nokia/ECG-PPG-integrated-electronic-stethoscope/docs/Patchkeeper_data_packet_info_V3x.docx

# Patchkeeper data format details

#### Packet head info:

typedef struct packet_info_struct {

uint32_t sop;

uint32_t timestamp_hi; // If we represent this as 64-bit we have alignment issues with padding added

uint32_t timestamp_lo; // So send as two 32-bit numbers and put together in the app.

uint8_t logger_id;

uint8_t custom; // Makes the structure end 32-bit aligned;

uint16_t length;

} packet_info_t;

## Config packet format:

// FIRMWARE VERSION information define at the beginning of sdk_config.h file
# define FIRMWARE_VERSION_ID FIRMWARE_MAJOR_VERSION * 1 00 00 00 + \
FIRMWARE_MINOR_VERSION * 1 00 00 + \
FIRMWARE_PATCH_NUM * 1 00 + \
FIRMWARE_BUILD_NUM

Example for version 1012: 1000102, saved as 4 bytes integral

#define LOGGER_CONFIG_DATA_LENGTH_BYTES 32
#define LOGGER_CONFIG_ID 0x00

typedef struct {
packet_info_t packet_info;
int8_t data[LOGGER_CONFIG_DATA_LENGTH_BYTES]; // 32 bytes of data
} config_data_t;

config_data.packet_info.sop = SOP_BELLLABS;
config_data.packet_info.timestamp_lo = timestamp.lo;
config_data.packet_info.timestamp_hi = timestamp.hi;
config_data.packet_info.logger_id = LOGGER_CONFIG_ID;
config_data.packet_info.length = LOGGER_CONFIG_DATA_LENGTH_BYTES; //32
config_data.packet_info.custom = packet_count++;

### packet info format:

6C-6C-65-42 | -00-00-00-00 | -A4-EA-5C-00 | -00 | -00-00 | -20
SOP_BELLLABS: lleB | timestamp.hi ts_hi: | timestamp.lo ts_lo: 4 bytes | logger ID: 0x00 config data | packet_count | data length (max 242) 0x20 : 32 bytes
4 bytes | 4 bytes | 4 bytes | 1 byte | 1 byte | 2 bytes

### 242 = 242 (244 -2 because of packet_count)

### then followed by config data:

### Followed by config data info (32 bytes in the following format, data length in header should be 0x20):

// Change the pointer type so it is transferred correctly.
uint32_t *data32 = (uint32_t*) config_data.data;
uint16_t *data16 = (uint16_t*) config_data.data;

*data32 = NRF_RTC2->PRESCALER;
*(data16+2) = RTC_INPUT_FREQ;
*(data16+3) = CONFIG_DATA_VERSION;

*(data32+2) = m_timestamp_offset.lo;
*(data32+3) = m_timestamp_offset.hi;
*(data32+4) = m_old_timestamp_offset.lo;
*(data32+5) = m_old_timestamp_offset.hi;
*(data32+6) = FIRMWARE_VERSION_ID;
*(data32+7) = m_last_reset_reason;

config data format:

NRF_RTC2->PRESCALER | RTC_INPUT_FRE | CONFIG_DATA_VERSION | m_timestamp_offset.lo | m_timestamp_offset.hi | m_old_timestamp_offset.lo | m_old_timestamp_offset.hi | FIRMWARE_VERSION_ID | m_last_reset_reason
4 bytes | 2 bytes | 2 bytes | 4 bytes | 4 bytes | 4 bytes | 4 bytes | 4 bytes | 4 bytes

Python script for processing config data:

def process_config_data(SensorData):

global PrescalerValue

global RTCInputFrequency

global Ticks_per_second

global DataPackingVersion

# print("Config Data Handler")

PrescalerValue = (SensorData[3] << 24 | SensorData[2] << 16 << SensorData[1] << 8 | SensorData[0])

RTCInputFrequency = (SensorData[5] << 8 | SensorData[4])

DataPackingVersion = (SensorData[7] << 8 | SensorData[6])

print("Updating PrescalarValue to ", PrescalerValue)

print("Updating RTC Input Frequency to ", RTCInputFrequency)

print("Data Format Version(should be 3): ", DataPackingVersion)

Ticks_per_second = RTCInputFrequency / (PrescalerValue + 1)

return

## Data packet format from all Sensors

Battery 0x05 6C-6C-65-42-00-00-00-00-7F-4B-78-00-05-02-17-00-56-D8-00-00

IMU: 0x2A 6C-6C-65-42-00-00-00-00-56-4F-78-00-2A-10-C1-12-03-00-09-00-03-00-68-04-12-00-F7-BC-D6-24-5D-00

GSR:0x22 6C-6C-65-42-00-00-00-00-DD-51-78-00-22-10-60-00-79-4B-78-00-00-90-19-40-DD-51-78-00-00-90-19-40

Strain: 0x24 6C-6C-65-42-00-00-00-00-E1-51-78-00-24-10-60-00-7A-4B-78-00-01-F4-3F-40-E1-51-78-00-01-F4-3F-40

Pulse: 0x26 6C-6C-65-42-00-00-00-00-E9-51-78-00-26-10-60-00-7B-4B-78-00-01-F4-3F-40-E9-51-78-00-01-F4-3F-40

Temperture 0x28: 6C-6C-65-42-00-00-00-00-82-4B-78-00-28-10-77-00-86-CB-77-00-01-F4-3F-40-82-4B-78-00-01-F4-3F-40

ECG: 0x02: 6C-6C-65-42-00-00-00-00-B7-9A-2D-00-20-E4-C5-01-B7-9A-2D-00-01-00-7F-FF-FF-01-12-F2-61-9B-2D-00-01-01-7F-FF-FF-01-13-15-67-9C-2D-00-01-02-7F-FF-FF-01-13-70-6D-9D-2D-00-01-03-7F-FF-FF-01-13-39-74-9E-2D-00-01-04-7F-FF-FF-01-13-3E-0F-A1-2D-00-01-05-7F-FF-FF-01-13-4B-87-A1-2D-00-01-06-7F-FF-FF-01-13-17-8E-A2-2D-00-01-07-7F-FF-FF-01-13-16-94-A3-2D-00-01-08-7F-FF-FF-01-13-2D-9A-A4-2D-00-01-09-7F-FF-FF-01-13-33-7A-A7-2D-00-01-0A-7F-FF-FF-01-13-51-AE-A7-2D-00-01-0B-7F-FF-FF-01-13-64-B4-A8-2D-00-01-0C-7F-FF-FF-01-13-64-BA-A9-2D-00-01-0D-7F-FF-FF-01-13-58-C1-AA-2D-00-01-0E-7F-FF-FF-01-13-43-DB-AD-2D-00-01-0F-7F-FF-FF-01-13-35-DB-AE-2D-00-01-10-7F-FF-FF-01-13-44-E2-AF-2D-00-01-11-7F-FF-FF-01-13-79-E7-B0-2D-00-01-12-7F-FF-FF-01-13-6A

16 bytes packet_info + subpackets

typedef struct {
packet_info_t packet_info;
adc_sensor_data_buffer_t data[PATCHKEEPER_TEMP_BUFFER_SIZE];
} patchkeeper_temp_data_t;

### Packet head info:

typedef struct packet_info_struct {

uint32_t sop;

uint32_t timestamp_hi; // If we represent this as 64-bit we have alignment issues with padding added

uint32_t timestamp_lo; // So send as two 32-bit numbers and put together in the app.

uint8_t logger_id;

uint8_t custom; // Makes the structure end 32-bit aligned;

uint16_t length;

} packet_info_t;

| | Bytes | bits
6C-6C-65-42 | lleB | 4 | 32
-00-00-00-00 | timestamp_hi | 4 | 32
-30-71-06-00 | timestamp_lo | 4 | 32
-22 (24, 26 0r 28) | logger_id | 1 | 8
-05 | data subpacket count (cycling 0-255): 0x05 | 1 | 8
-E4-00 | length0x00E4(LSB first): it changes from 1 byte (V2 and before)to 2 bytes (V3) for streaming/save large amount of data without a new header. Custom for subpacket counting reduced to 1 byte: 0x10: 16 bytes for 2 readings of each sensor : ts_lo (4) and float_t (4) 0xE4: 228bytes for ECG 0x02: 2 bytes for battery percentage and coded voltage (padded with 2 bytes of 0 for saving and streaming) 0x10: 16 bytes for IMU: 2 bytes each value gyro.x, y, z, accel.x, y, z, ts_lo (4) 0x04: 4 bytes for Audio mean and peak, 2 bytes each (16 bits integral) | 2 | 16
Then followed by | 20 sub-packets of this: total 160 bytes | 16 bytes of header for all BLE packets
-DF-0C-05-00 | : timestamp_lo of individual sub-packet | 4 | 32
-CE-BC-54-40 | : float 32 bit float_t data (reading of voltage): 3.32402 | 4 | 32
-AC-19-05-00 | :second sub-packet, timestamp_lo of individual packet | 4 | 32
-CE-74-54-40 | :second packet,t 32 bit float_t data (voltage) : 3.31963 | 4 | 32

## length of following data: multiples of subpackets:

## 16 bytes for analog sensor data, multiple of 8 bytes

## 228 for ECG data, multiple of 12 bytes

## IMU and battery data are the same as in Gecko device.

## 2 bytes for battery data:

Analog sensors: 8 bytes x 2 data points (4 bytes for ts_lo and 4 bytes for float value)

ECG: 12 bytes x 19 supbackets

Batt: 2 bytes x 1 reading //PATCHKEEPER_BATT_DATA_LENGTH_BYTES

Audio mean and peak: PATCHKEEPER_AUDIO_RESULT_DATA_LENGTH_BYTES*sizeof(audio_memory_t);

#### IMU sensor data subpacket format:

#define PATCHKEEPER_IMU_DATA_LENGTH_BYTES 16

#define PATCHKEEPER_IMU_DATA_LENGTH_HALF_WORDS PATCHKEEPER_IMU_DATA_LENGTH_BYTES/2

#define PATCHKEEPER_IMU_ID 0x2a

typedef struct {
packet_info_t packet_info;
int16_t data[PATCHKEEPER_IMU_DATA_LENGTH_HALF_WORDS]; = data[8]
} imu_data_t;

typedef struct {
bmi160_sensor_data_simple_t gyro_data;
bmi160_sensor_data_simple_t accel_data;
uint32_t sensortime;

} imu_data_packed_t;

6C-6C-65-42 | -00-00-00-00 | -A4-EA-5C-00 | -2A | -10-00 | -79 | -FE-FF | -F9-FF | -FE-FF | -5E-04 | -8C-00 | -FE-BC | -C1-EC- -47-00
lleB | ts_hi | ts_lo | 0x2A for IMU | length:0x10: means 16 bytes data | custom : sequence | gyro.x | gyro.y | gyro.z | accel.x | accel.y | accel.z | imu_internal_ts
4 bytes | 4 bytes | 4 bytes | 1 byte | 2 bytes | 1 byte | 2 | 2 | 2 | 2 | 2 | 2 | 4

##### python scripts for processing IMU data (from Gecko):

def process_imu_data(SensorData):

# gx = int(SensorData[1] << 8 | SensorData[0])

# gy = int(SensorData[3] << 8 | SensorData[2])

# gz = int(SensorData[5] << 8 | SensorData[4])

# ax = int(SensorData[7] << 8 | SensorData[6])

# ay = int(SensorData[9] << 8 | SensorData[8])

# az = int(SensorData[11] << 8 | SensorData[10])

gx = 125*3.14159/(2**16*180)*int.from_bytes(SensorData[0:2],byteorder='little',signed=True)

gy = 125*3.14159/(2**16*180)*int.from_bytes(SensorData[2:4],byteorder='little',signed=True)

gz = 125*3.14159/(2**16*180)*int.from_bytes(SensorData[4:6],byteorder='little',signed=True)

ax = 9.80665/2**14*int.from_bytes(SensorData[6:8],byteorder='little',signed=True)

ay = 9.80665/2**14*int.from_bytes(SensorData[8:10],byteorder='little',signed=True)

az = 9.80665/2**14*int.from_bytes(SensorData[10:12],byteorder='little',signed=True)

imu_internal_ts = (SensorData[14] << 16 | SensorData[13] << 8 | SensorData[12])

return {'type':'imu_ts','gx':gx,'gy':gy,'gz':gz,'ax':ax,'ay':ay,'az':az,'imu_internal_ts':imu_internal_ts}

#### Analog sensors data format:

### PATCHKEEPER_GSR_ID 0x22

### PATCHKEEPER_STRAIN_ID 0x24

### PATCHKEEPER_PULSE_ID 0x26

### PATCHKEEPER_TEMP_ID 0x28

#define PATCHKEEPER_GSR_BUFFER_SIZE 2
#define PATCHKEEPER_STRAIN_BUFFER_SIZE 2

#define PATCHKEEPER_PULSE_BUFFER_SIZE 2

#define PATCHKEEPER_TEMP_BUFFER_SIZE 2

typedef struct {
uint32_t ts_lo; // 4 bytes
float_t value; // 4 bytes
} adc_sensor_data_buffer_t; // 8 bytes total

typedef struct {
packet_info_t packet_info;
adc_sensor_data_buffer_t data[PATCHKEEPER_GSR_BUFFER_SIZE];
} patchkeeper_gsr_data_t;

typedef struct {
packet_info_t packet_info;
adc_sensor_data_buffer_t data[PATCHKEEPER_STRAIN_BUFFER_SIZE];
} patchkeeper_strain_data_t;

typedef struct {
packet_info_t packet_info;
adc_sensor_data_buffer_t data[PATCHKEEPER_PULSE_BUFFER_SIZE];
} patchkeeper_pulse_data_t;

typedef struct {
packet_info_t packet_info;
adc_sensor_data_buffer_t data[PATCHKEEPER_TEMP_BUFFER_SIZE];
} patchkeeper_temp_data_t;

#define PATCHKEEPER_GSR_DATA_LENGTH_BYTES PATCHKEEPER_GSR_BUFFER_SIZE * sizeof(adc_sensor_data_buffer_t)

#define PATCHKEEPER_STRAIN_DATA_LENGTH_BYTES PATCHKEEPER_STRAIN_BUFFER_SIZE * sizeof(adc_sensor_data_buffer_t)
#define PATCHKEEPER_PULSE_DATA_LENGTH_BYTES PATCHKEEPER_PULSE_BUFFER_SIZE * sizeof(adc_sensor_data_buffer_t)
#define PATCHKEEPER_TEMP_DATA_LENGTH_BYTES PATCHKEEPER_TEMP_BUFFER_SIZE * sizeof(adc_sensor_data_buffer_t)

6C-6C-65-42 | -00-00-00-00 | -DD-51-78-00 | -22 | -10-00 | -60 | -79-4B-78-00 | -00-90-19-40 | -DD-51-78-00 | -00-90-19-40
lleB | ts_hi | ts_lo | 0x22/ 0x24/ 0x26/ 0x28 | length:0x10: 16 bytes data | custom 1 byte: sequence No. of packets | ts_lo1: 4 bytes | adc reading1, float_t: 4 bytes | ts_lo2: 4 bytes | adc reading2, float_t, 4bytes
4 bytes | 4 bytes | 4 | 1 | 2 | 1 | 4 | 4 | 4 | 4

#### Battery data format

There is no subpacket for battery data:

typedef struct {
packet_info_t packet_info;
uint8_t data[PATCHKEEPER_BATT_DATA_LENGTH_BYTES];
} patchkeeper_batt_data_t;

### PATCHKEEPER_BATT_ID 0x05

#define PATCHKEEPER_BATT_BUFFER_SIZE 1

#define PATCHKEEPER_BATT_DATA_LENGTH_BYTES PATCHKEEPER_BATT_BUFFER_SIZE * sizeof(nrf_saadc_value_t) // 1X16 Bits

Battery :

6C-6C-65-42 | -00-00-00-00 | -7F-4B-78-00 | -05 | -02-00 | -17 | -56 | -D8 | -00-00
lleB | ts_hi: 4 bytes | ts_lo: 4 bytes | 0x05: Battery_ID | length:0x02: means 2 bytes data | custom 1 byte: sequence No. of packets | battery_level_Percent (86%) | coded_vbatt_8: 216 in decimal | padded for alignment 32 bits
4 bytes | 4 | 4 | 1 | 2 | 1 | 1 | 1 | 2

python processing battery data (from Gecko):

def process_battery_data(SensorData):

battery_percent = (SensorData[0])

if (DataPackingVersion>=1):

battery_volt = 3.0 + SensorData[1]/200.0;

else:

battery_volt = (SensorData[1]+300.0)/100.0;

battery_level = battery_volt

return {'type':'battery_ts','battery_percent':battery_percent,'battery_level':battery_level}

#### ECG data subpacket format

Each ECG BLE packet contains: 16 bytes of header + 19 subpackets of data, total length = 12 x 19 = 228 bytes

Total bytes: 16+12 x 19 =244 each BLE packet

(To make receiving end parsing data easier, all data packets are formatted with header (16 bytes),

therefor maximum number of subpackets : 19 ( (244 -16)/12 = 19 ))

PATCHKEEPER_ECG_ID 0x20, data as following:

6C-6C-65-42-00-00-00-00-74-83-07-00-20-E4-47-000-74-83-07-00-01-00-7F-FF-FF-2B-B9-89-44-84-07-00-01-01-7F-FF-FF-2B-B4-E9-4B-85-07-00-01-02-7F-FF-FF-2B-B0-08-51-86-07-00-01-03-7F-FF-FF-2B-AA-9F-D9-89-07-00-01-04-7F-FF-FF-2B-9A-1D-6B-8A-07-00-01-05-7F-FF-FF-2B-95-27-71-8B-07-00-01-06-7F-FF-FF-2B-90-1B-78-8C-07-00-01-07-7F-FF-FF-2B-8A-63-7E-8D-07-00-01-08-7F-FF-FF-2B-85-1D-3E-90-07-00-01-09-7F-FF-FF-2B-7A-4B-91-90-07-00-01-0A-7F-FF-FF-2B-75-0A-97-91-07-00-01-0B-7F-FF-FF-2B-70-00-9E-92-07-00-01-0C-7F-FF-FF-2B-6B-12-A4-93-07-00-01-0D-7F-FF-FF-2B-66-13-A4-96-07-00-01-0E-7F-FF-FF-2B-5B-23-BA-96-07-00-01-0F-7F-FF-FF-2B-55-BF-BE-97-07-00-01-10-7F-FF-FF-2B-50-A8-C4-98-07-00-01-11-7F-FF-FF-2B-4B-21-CB-99-07-00-01-12-7F-FF-FF-2B-45-74

6C-6C-65-42 | -00-00-00-00 | -74-83-07-00 | -20 | -E4-00 | -47 | -74-83-07-00 | -01- | -00- | -7F-FF-FF | --2B-B9-89
lleB | ts_hi: 4 bytes | ts_lo: 4 bytes | 0x20 ECG_ID | length:0xE4: means 228 bytes data | custom 1 byte: sequence No. of packets | ts_lo1: 4 bytes, time stamp of each data point | 1 byte status from ADS1992 | 1 byte subpacket count | 3 bytes of channel 1 data | 3 bytes of channel 2 data
4 bytes | 4 | 4 | 1 | 2 | 1 | 4 | 1 | 1 | 3 | 3

The above grey part repeats 19 time in each packet, with subpacket counts changes from 0x00 to 0x12

subpacket format:

typedef struct {
uint32_t timestamp_lo;
uint8_t status;
uint8_t packet_count; //for memory allocation alignment
uint8_t channel1_data[3];
uint8_t channel2_data[3];

} ads1292r_packet_t;

12 bytes each subpacket, since at least 10 bytes required for each data packets, use 12 bytes for struct data alignment, with status and packet count

#### Audio mean and average data subpacket format

typedef int16_t audio_memory_t; // 2bytes

#define PATCHKEEPER_AUDIO_ID 0x04
#define PATCHKEEPER_AUDIO_RESULT_BUFFER_SIZE 1
#define PATCHKEEPER_AUDIO_RESULT_DATA_LENGTH_BYTES PATCHKEEPER_AUDIO_RESULT_BUFFER_SIZE*2*sizeof(audio_memory_t) // 4 bytes

typedef struct {
packet_info_t packet_info;
audio_memory_t data[PATCHKEEPER_AUDIO_RESULT_DATA_LENGTH_BYTES]; = data[2]
} audio_data_t;

Audio mean and peak:

6C-6C-65-42 | -00-00-00-00 | -7F-4B-78-00 | -04 | -02-00 | -17 | -56-D8 | -00-00
lleB | ts_hi: 4 bytes | ts_lo: 4 bytes | 0x04: audo ID | length:0x02: means 2 bytes data | custom 1 byte: sequence No. of packets | audio mean | audio peak
4 bytes | 4 | 4 | 1 | 2 | 1 | 2 | 2

audio mean and peak range: from -32768 to 32767

python parsing audio data:

def process_audio_data(SensorData):

audio_mean = (SensorData[1] << 8 | SensorData[0])

audio_peak = (SensorData[3] << 8 | SensorData[2])

#### Audio raw data format

Audio raw data was continuously saved to SD card (or can be streamed if needed, not fully test, might lost packages) as .ALOG file.

Data are two channels stereo format, with sampling rate 16124 and 16bit depth.

// audio data at 16.125kHz i.e. 8062 samples at 16 bit/sample -> 16124
#define AUDIO_MEMORY_SIZE_BYTES MEMORY_SIZE_KB(32)
#define AUDIO_MEMORY_NUM_BUFFERS 2
#define AUDIO_MEMORY_BUFFER_SIZE AUDIO_MEMORY_SIZE_BYTES/AUDIO_MEMORY_NUM_BUFFERS

AUDIO_MEMORY_BUFFER_SIZE 16k bytes

#### PPG data format (V10xxxxx firmware)

#define PATCHKEEPER_PPG_ID 0x2B

//#define PATCHKEEPER_CONFIG_PPG 0x2B

Each PPG data package contains a packet_info_t, followed by three uint32_t for green, red and infrared reading respectively:

typedef struct {

packet_info_t packet_info;

maxm86161_ppg_sample_t data;

} patchkeeper_ppg_data_t;

typedef struct {

uint32_t ppg0; ///< ppg1 sample data

uint32_t ppg1; ///< ppg2 sample data

uint32_t ppg2; ///< ppg3 sample data

} maxm86161_ppg_sample_t;

###### Default PPG sampling interval 30 seconds every 5 mins:

#define PATCHKEEPER_DEFAULT_PPG_SAMPLE_INTERVAL_MS 50

#define PATCHKEEPER_DEFAULT_PPG_DUTYCYCLE_INTERVAL_MS 300000 //5 mins

#define PATCHKEEPER_DEFAULT_PPG_ON_TIME_MS 30000 //30 seconds

6C-6C-65-42 | -00-00-00-00 | -7F-4B-78-00 | -2B | -0C-00 | -17 | -56-D8-43-00 | -63-00-76-00 | -12-34-76-00
lleB | ts_hi: 4 bytes | ts_lo: 4 bytes | 0x2B: PPG ID | length:0x0C: 12 bytes data | custom 1 byte: sequence No. of packets | 4 bytes: Green LED reading | 4 bytes: Infrared LED reading | 4 bytes: Red reading
4 bytes | 4 | 4 | 1 | 2 | 1 | 4 | 4 | 4

Processing with python:

MAXM86161_REG_FIFO_DATA_MASK = 0x07FFFF

MAXM86161_REG_FIFO_RES = 19

MAXM86161_REG_FIFO_TAG_MASK = 0x1F

block_buf = unpack_from('BBBB', SensorData,offset)

temp_data:int = block_buf[2] << 16 | block_buf[1] << 8 | block_buf[0]

data_val:int = temp_data & MAXM86161_REG_FIFO_DATA_MASK

tag:int = (temp_data >> MAXM86161_REG_FIFO_RES) & MAXM86161_REG_FIFO_TAG_MASK

#### PPG data format

#define PATCHKEEPER_PPG_ID 0x2B

To speed up PPG data processing, PPG sensor data were read with I2C (TWI) interface in buck mode, about 60 data points every FIFO_AFULL interrupt. Read data are saved/transmitted directly in one BLE packet. Each data point contains 3 bytes, first 5 bits for Tag and 19 bits for data (as described in maxm86161 datasheet p19):

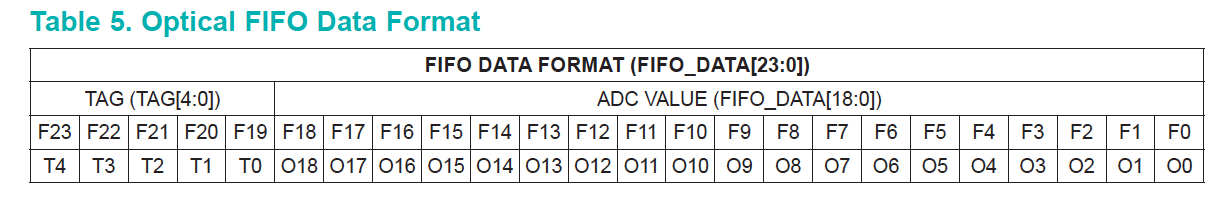
[picture p1: figure]

Number of data points in each batch read is in multiple of both 3 and 2 (30 or 60 used), this is for easy data processing as PPG is configured to use all 3 LEDs in each measurement (green, infrared and red in sequence). Therefore each timestamp corresponding to 3 data points for green, infrared and red LED.

Each PPG data package contains a packet_info_t, followed by three uint32_t for green, red and infrared reading respectively:

typedef struct {

packet_info_t packet_info;

maxm86161_ppg_bytes_t data;

} patchkeeper_ppg_bytes_t;

typedef struct {

uint8_t ppg_data_byte[3*128]; // ppg data bytes

} maxm86161_ppg_bytes_t;

###### Default PPG sampling interval 30 seconds every 5 mins:

#define PATCHKEEPER_DEFAULT_PPG_DUTYCYCLE_INTERVAL_MS 300000 //5 mins

#define PATCHKEEPER_DEFAULT_PPG_ON_TIME_MS 30000 //30 seconds

6C-6C-65-42 | -00-00-00-00 | -7F-4B-78-00 | -2B | -0C-00 | -17 | -56-D8-43 | -63-00-76 | -12-34-76 | -56-D8-43-
lleB | ts_hi: 4 bytes | ts_lo: 4 bytes | 0x2B: PPG ID | length:0xB4: 180 bytes data (this can change) | custom 1 byte: sequence No. of packets | 3 bytes: green LED reading | 3 bytes: Infrared LED reading | 4 bytes: red reading | More bytes for LED readings
4 bytes | 4 | 4 | 1 | 2 | 1 | 3 | 3 | 3 | 3X?

The length of the packet (total number of bytes) could change during the reading process due to availability of data and some other possible errors. For data parsing, three data points are processed each time for same timestamp, additional individual points that can not be grouped in 3 are disregarded. Tag is checked for every data point before putting to array. The following python script is used:

block_buf = unpack_from('BBB', SensorData,offset)

temp_data:int = block_buf[0] << 16 | block_buf[1] << 8 | block_buf[2]

data_val:int = temp_data & MAXM86161_REG_FIFO_DATA_MASK

tag:int = (temp_data >> MAXM86161_REG_FIFO_RES) & MAXM86161_REG_FIFO_TAG_MASK

print("tag:value : " + repr(tag)+" : "+ repr(data_val))

if tag == 1:

val1 = data_val

elif tag == 2:

val2 = data_val

elif tag == 3:

val3 = data_val

else:

print("No correct tag, point use previous value................................" )

break

offset += No_bytes_each_data
