nokia/ECG-PPG-integrated-electronic-stethoscope/docs/Patchkeeper Firmware updates.pdf

## Patchkeeper DFU OTA (Device firmware update over-the-air)

## Download nRF Connect

Versions for Mobile:
https://www.nordicsemi.com/Software-and-Tools/Development-Tools/nRF-Connect-formobile (https://www.nordicsemi.com/Software-and-Tools/Development-Tools/nRF-Connect-for-mobile)

Versions for computer

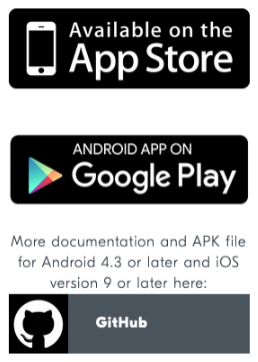
[picture p2: figure]

This guide is for updating firmware using mobile phone. nRF Connect APPs are also available for computer as well. “nRF Connect Bluetooth Low Energy” is the one to be used for checking BLE data packets and over the air firmware update.

Computer desktop version are also available, which can be downloaded here. (https://www.nordicsemi.com/Software-and-Tools/Development-Tools/nRF-Connect-for-desktop)
Here is the detailed instruction: https://infocenter.nordicsemi.com/index.jsp?topic=/struct_nrftools/struct/nrftools_nrfconnect.html&cp=8_3 (https://infocenter.nordicsemi.com/index.jsp?cp=8_3)

Note: On macOS and Linux, you must download and install the SEGGER J-Link Software (https://www.segger.com/downloads/jlink/#J-LinkSoftwareAndDocumentationPack) separately and may need DK hardware from Nordic.

## Step-by-step DFU OTA on iPhone (with screenshots)

1) Open the APP
2) The APP will scan for BLE devices automatically, turn on your Patchkeeper device. It will be shown as Belt_xxxx.

3) Click Connect button

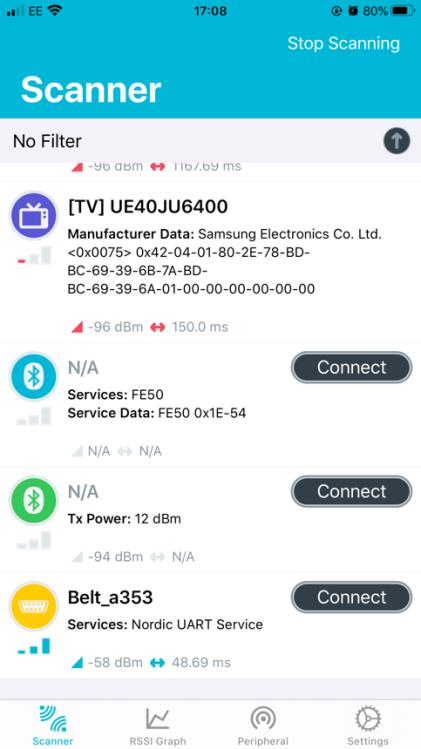
[picture p3: figure]

4) Once connected, you will see the following screen with information from the Patchkeeper device.
5) Click on DFU button as shown in the red circle.

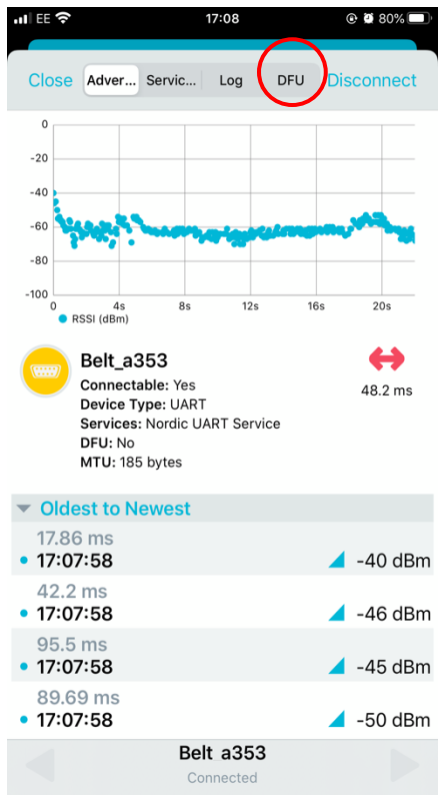
[picture p4: figure]

6) You will be prompt to choose your file. On iPhone, the file is usually stored in iCould for this purpose.
7) Select the corresponding zip file you would like to use.

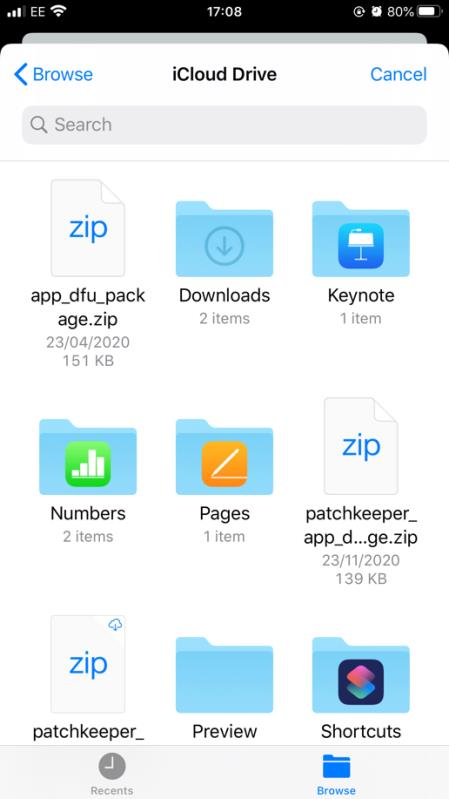
[picture p5: figure]

8) You will have this screen, with information about the zip file contents.
9) You are ready to click Start button.

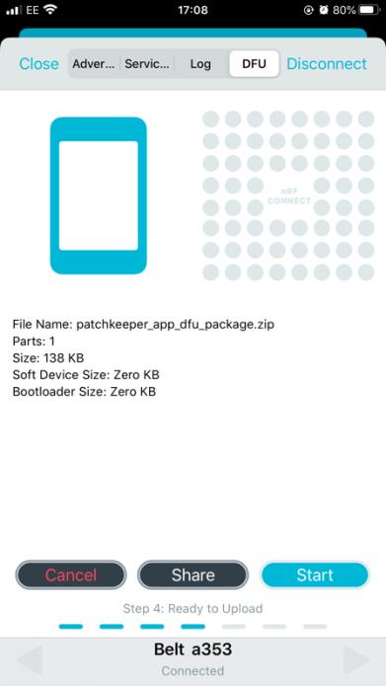
[picture p6: figure]

10) Once finished, you should see the following screen and you can use you Patchkeeper again.

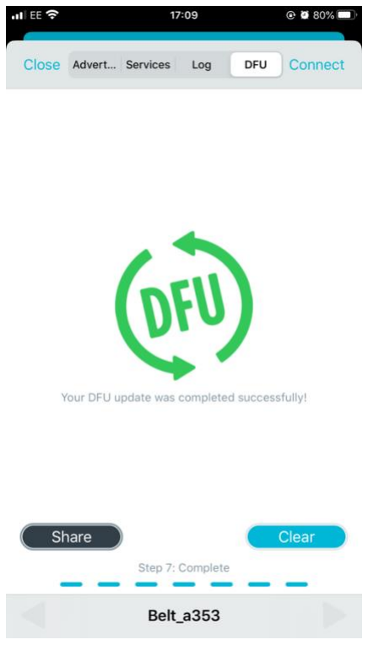
[picture p7: figure]
