nokia/ECG-PPG-integrated-electronic-stethoscope/ECG-PPG-integrated-electronic-stethoscope-hw/BOM/Bill of Materials-Flex_ECG_Connector.csv

Designator | Comment | Quantity | Description
J1 | FFC_connector | 1 | FFC/FPC Connector, 4 pin plug, pitch 0.5mm, 0.3mm strip
