nokia/ECG-PPG-integrated-electronic-stethoscope/ECG-PPG-integrated-electronic-stethoscope-hw/AutoCAD PCB/Flex_ECG_Connector_newshape.DXF

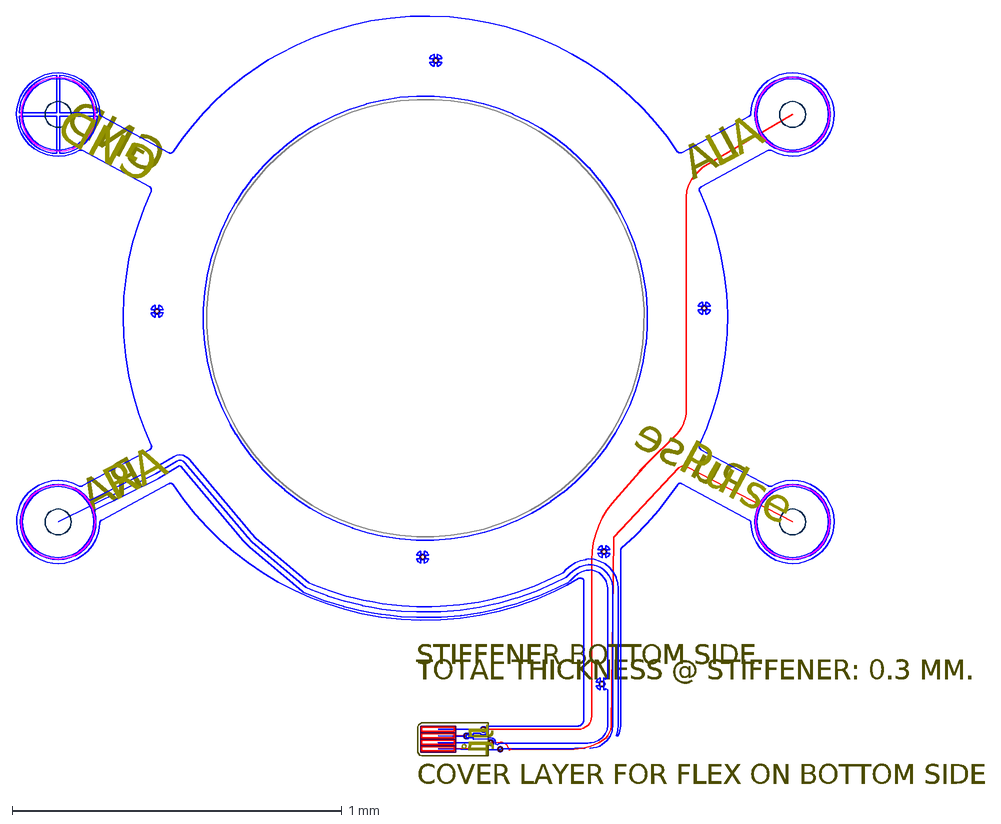
[picture p8: CAD file, 2022-12-14]
ECG-PPG-integrated-electronic-stethoscope-hw/AutoCAD PCB/Flex_ECG_Connector_newshape.DXF
RA
GND
LA
Pulse
J1
STIFFENER BOTTOM SIDE.
TOTAL THICKNESS @ STIFFENER: 0.3 MM.
COVER LAYER FOR FLEX ON BOTTOM SIDE
