nokia/ECG-PPG-integrated-electronic-stethoscope/ECG-PPG-integrated-electronic-stethoscope-hw/STEP_files/Flex_PPG_014_addbending_swappedConectors.step

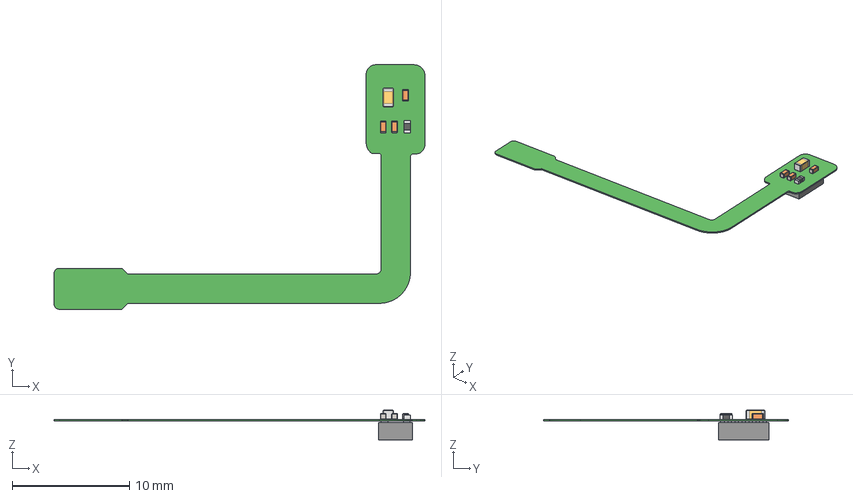
[picture p9: CAD file, 2022-12-14]
ECG-PPG-integrated-electronic-stethoscope-hw/STEP_files/Flex_PPG_014_addbending_swappedConectors.step
31.7 x 20.9 x 2.54 mm
Extruded x 3
Pins
User_Library-0402(1005M)_Cap x 3
User_Library-Chip_Capacitor_0603
