nokia/ECG-PPG-integrated-electronic-stethoscope/ECG-PPG-integrated-electronic-stethoscope-hw/AutoCAD PCB/Flex_PPG_014_addbending_swappedConectors.DXF

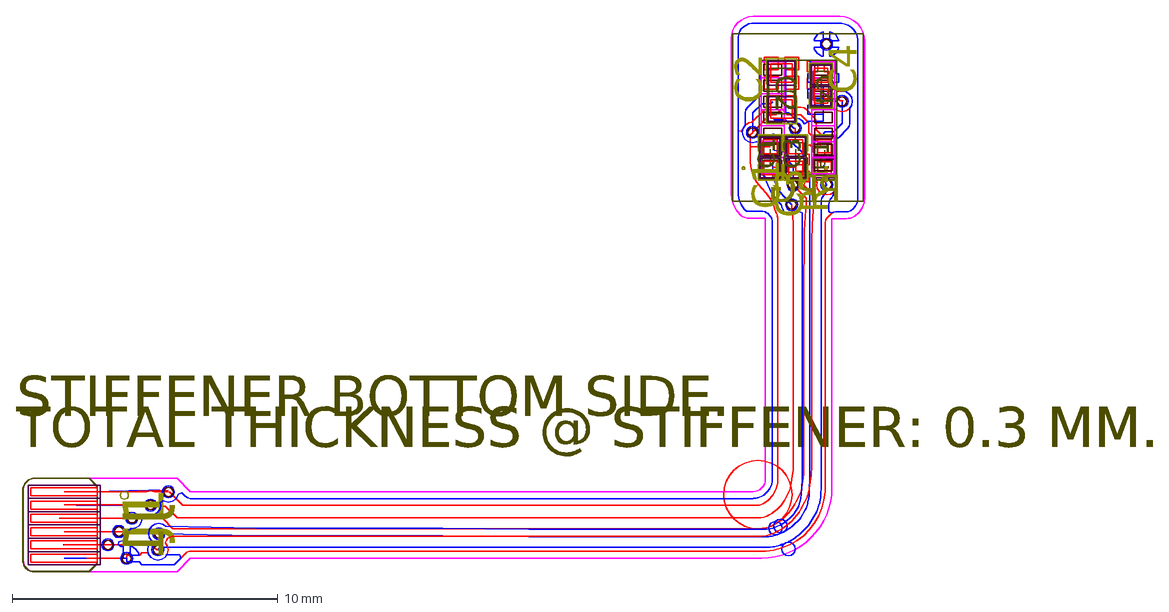
[picture p10: CAD file, 2022-12-14]
ECG-PPG-integrated-electronic-stethoscope-hw/AutoCAD PCB/Flex_PPG_014_addbending_swappedConectors.DXF
J1
STIFFENER BOTTOM SIDE.
TOTAL THICKNESS @ STIFFENER: 0.3 MM.
R1
PPG
C1
C2
C3
C4
