nokia/ECG-PPG-integrated-electronic-stethoscope/ECG-PPG-integrated-electronic-stethoscope-hw/STEP_files/Flex_ECG_Connector_newshape.step

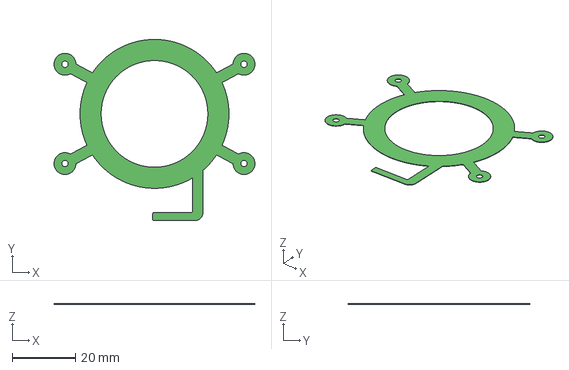
[picture p11: CAD file, 2022-12-14]
ECG-PPG-integrated-electronic-stethoscope-hw/STEP_files/Flex_ECG_Connector_newshape.step
63.5 x 57.2 x 0.141 mm
