nokia/ECG-PPG-integrated-electronic-stethoscope/ECG-PPG-integrated-electronic-stethoscope-hw/PDF/Flex_ECG_Connector.PDF

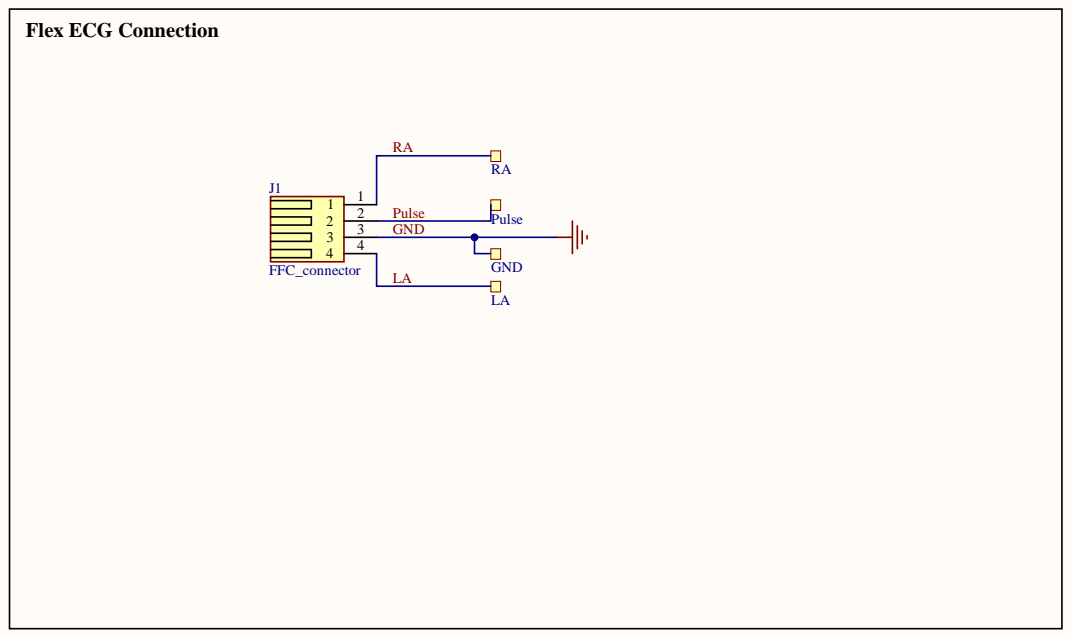
[picture p12: page 1]

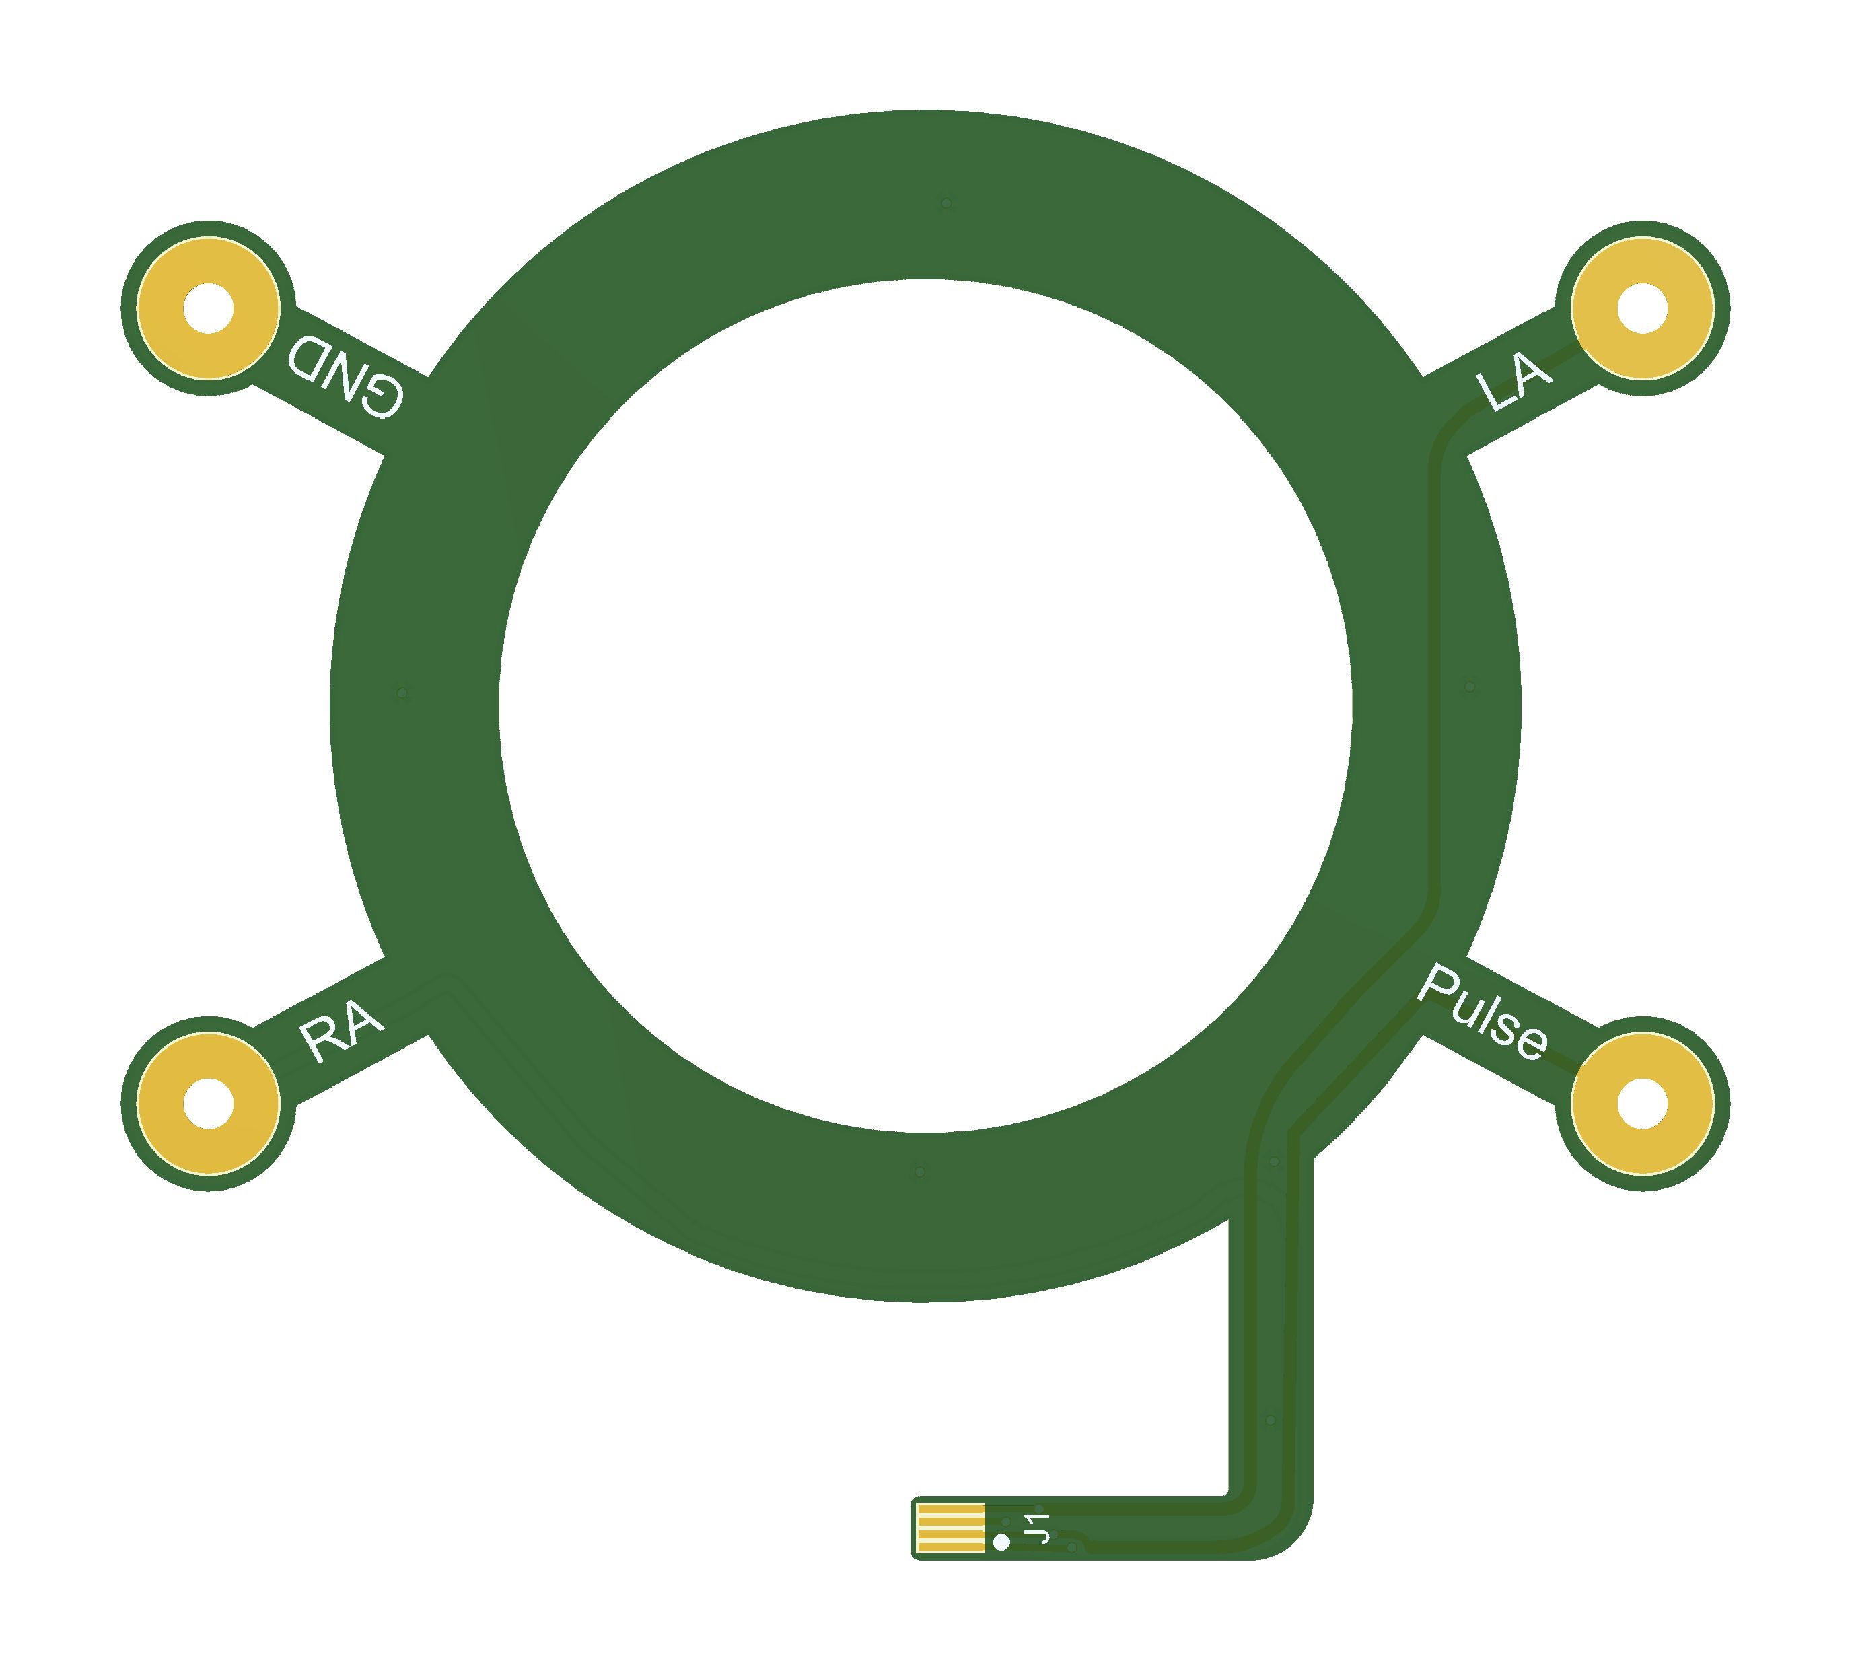
[picture p13: page 2]

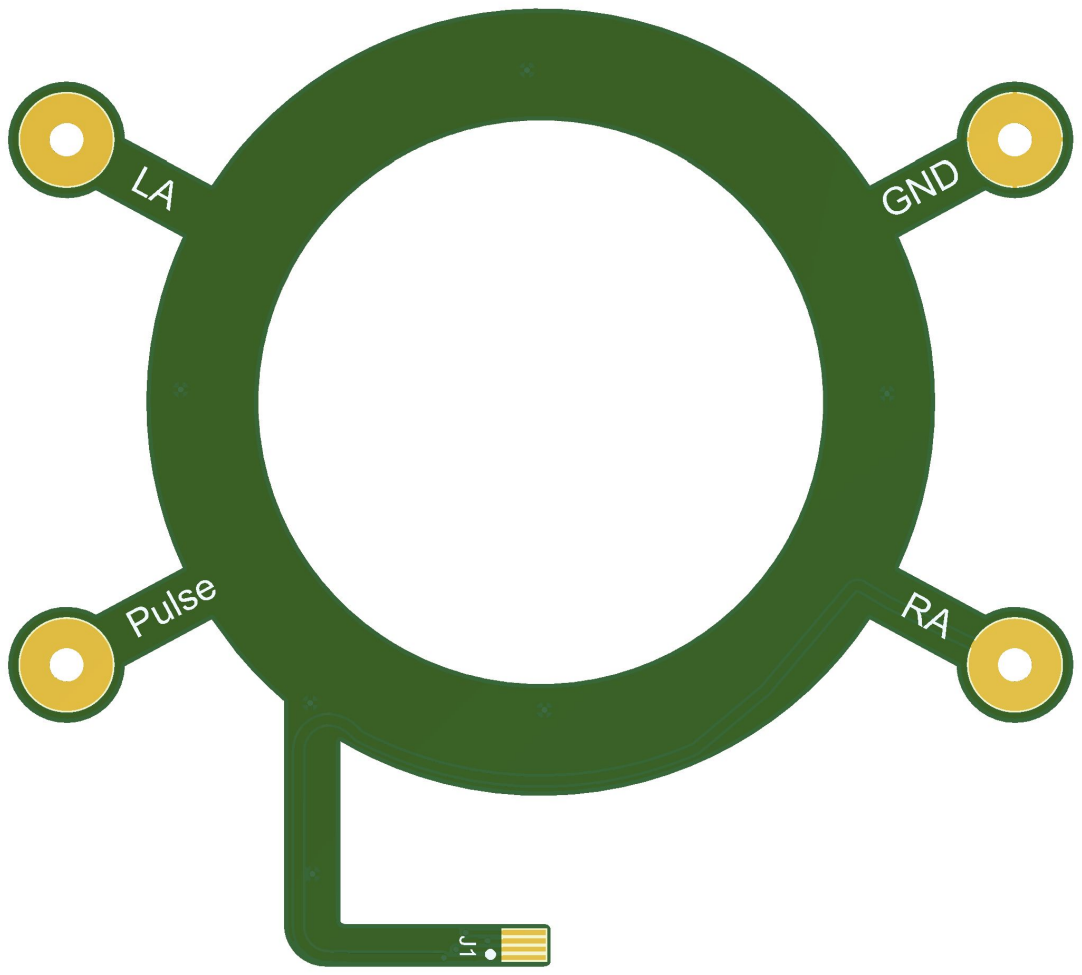
[picture p14: page 3]

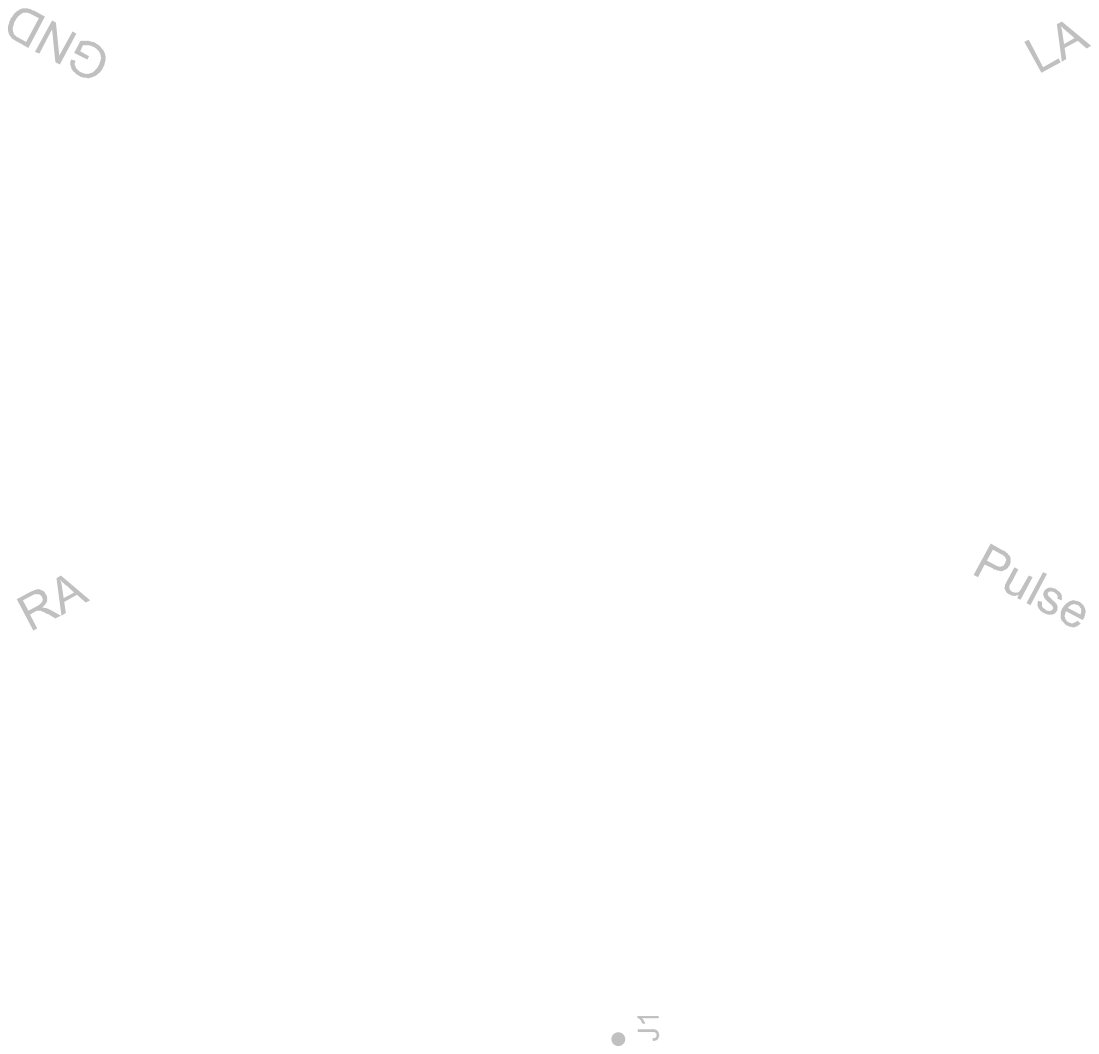
[picture p15: page 5]

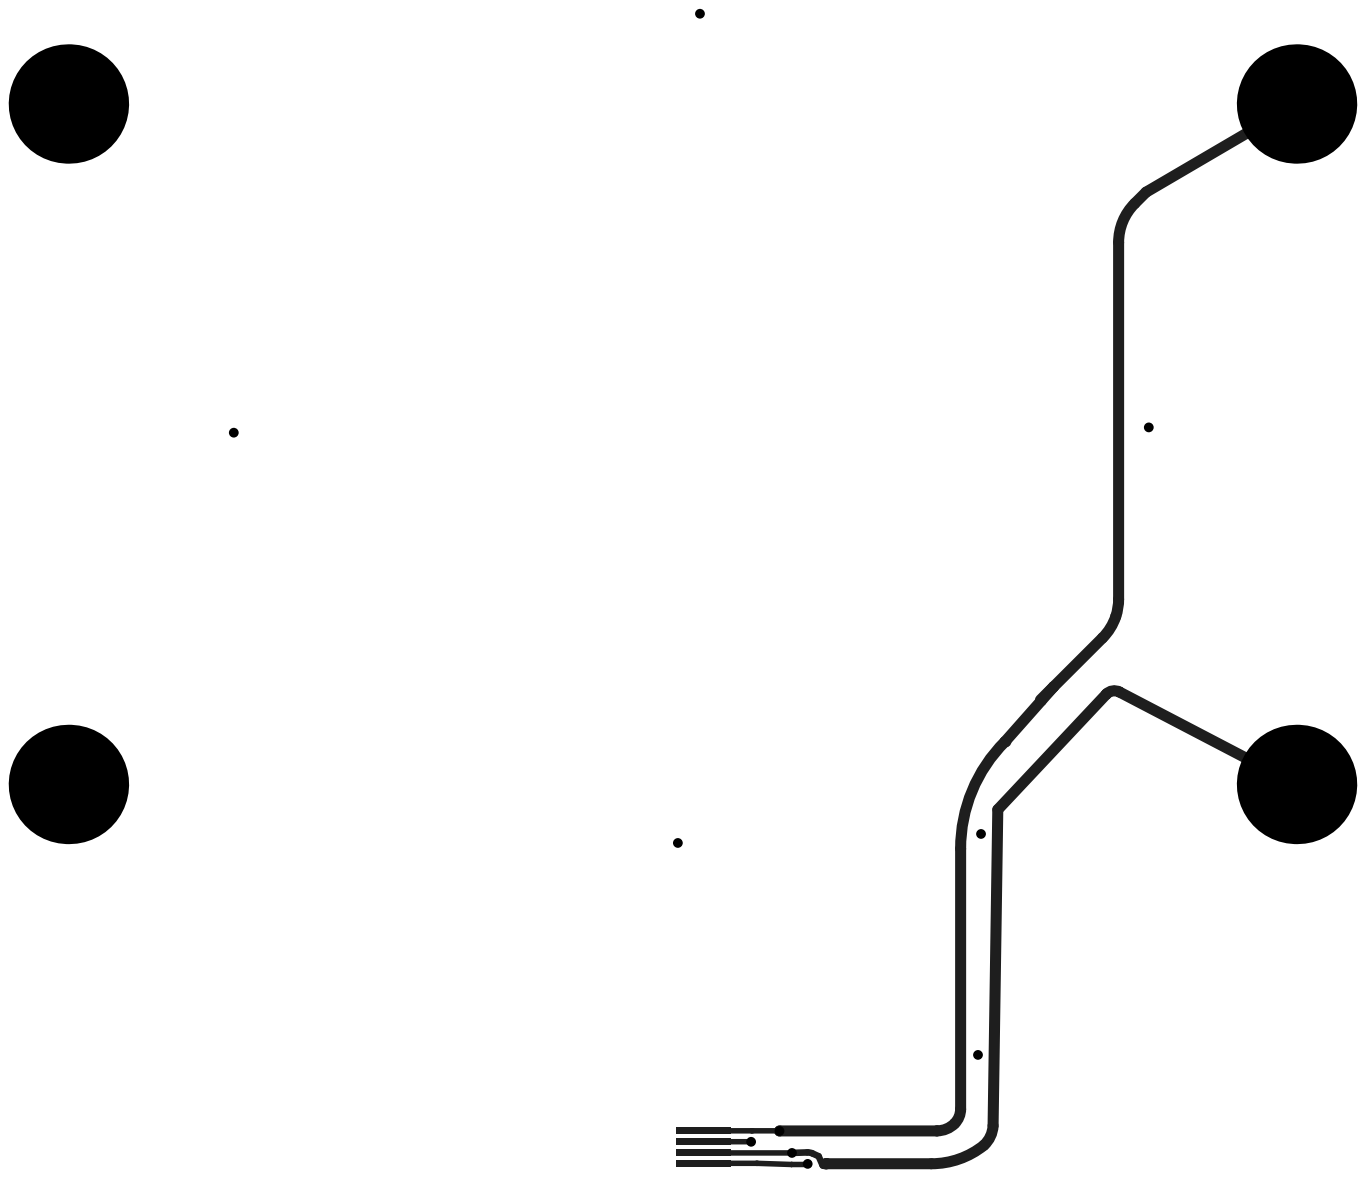
[picture p16: page 6]

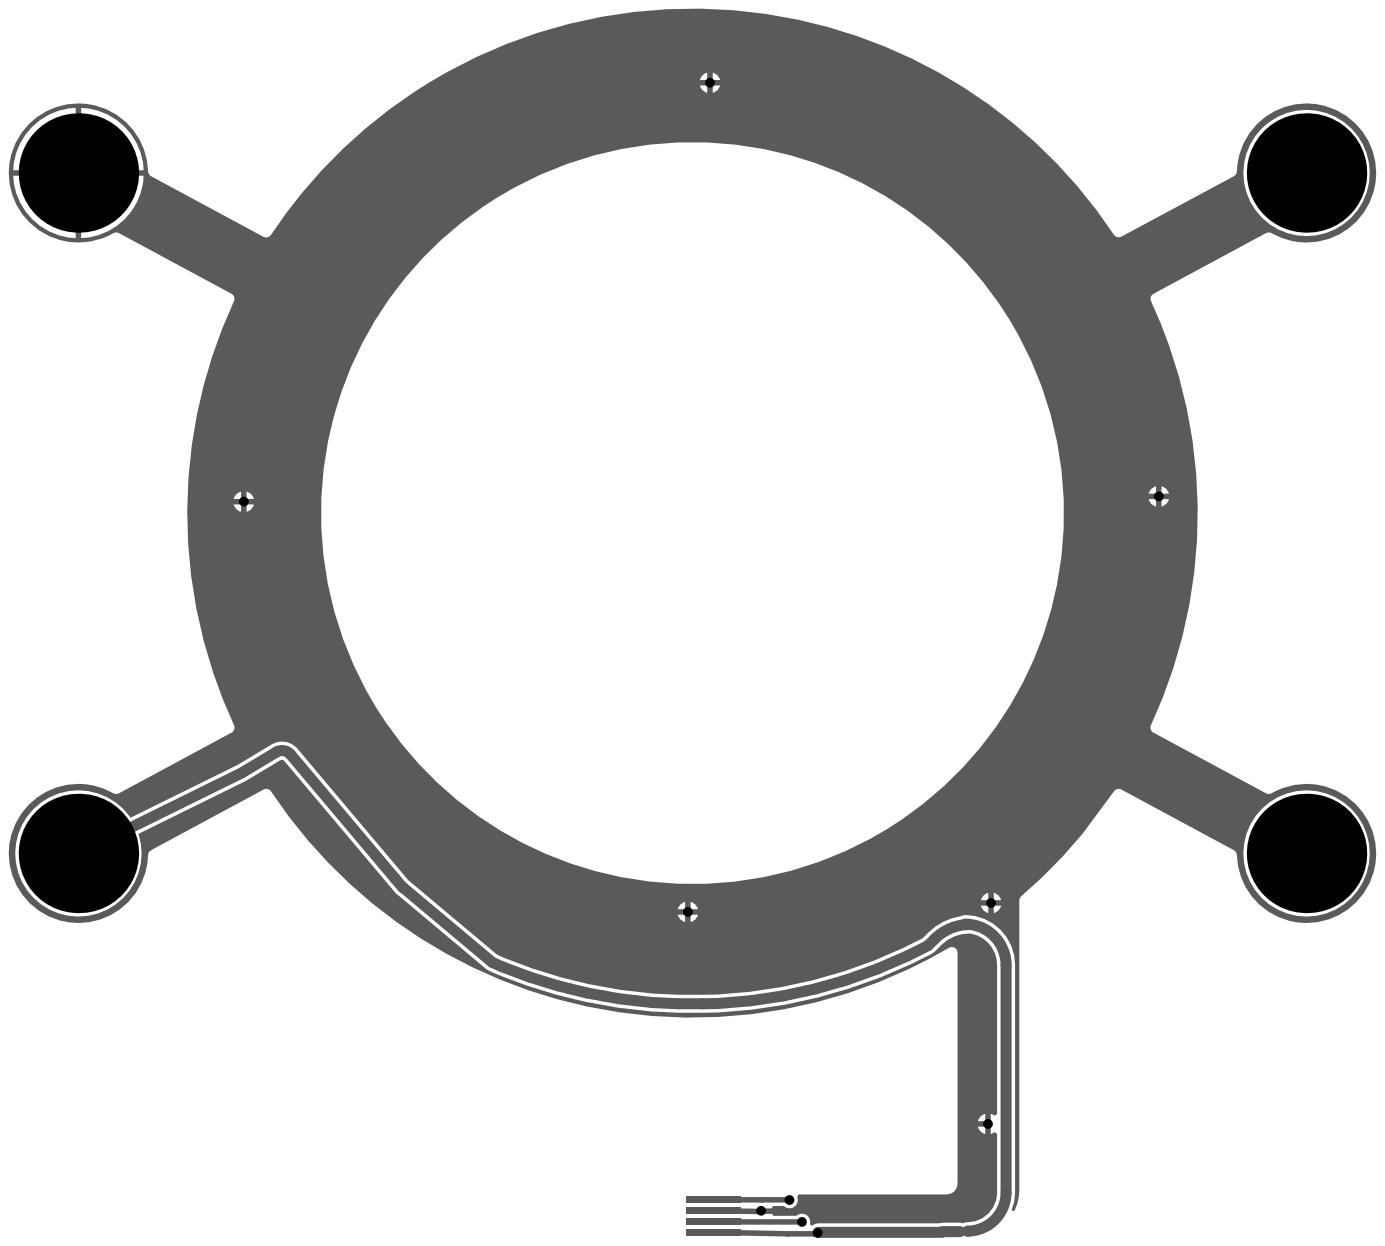
[picture p17: page 7]

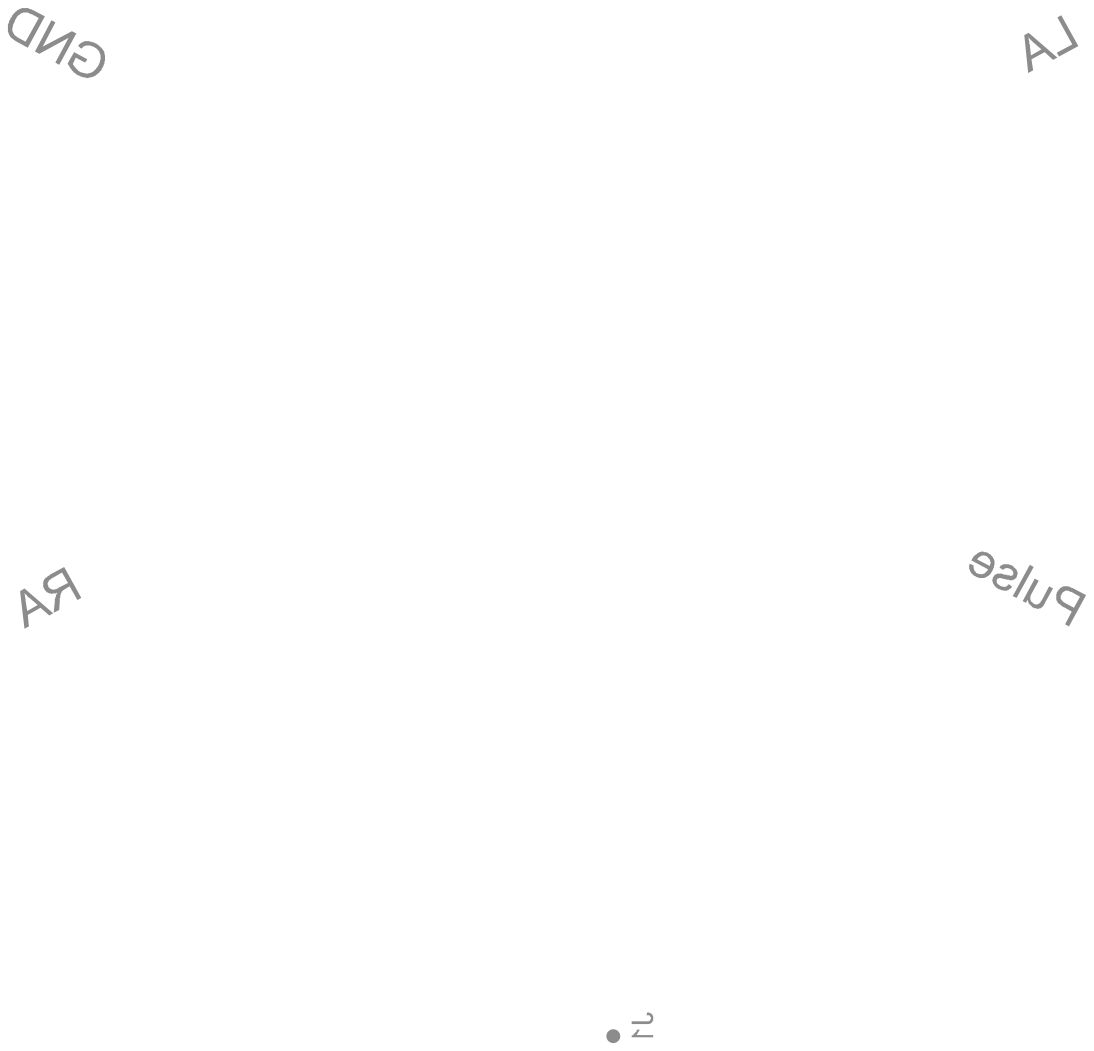
[picture p18: page 8]

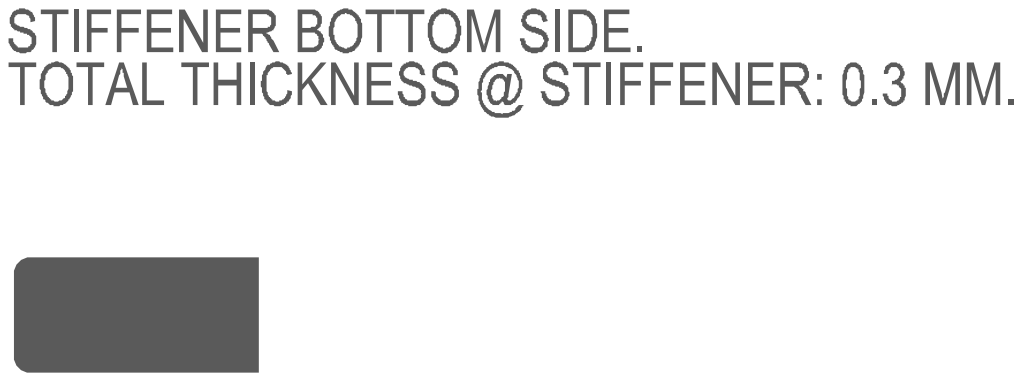
[picture p19: page 9]

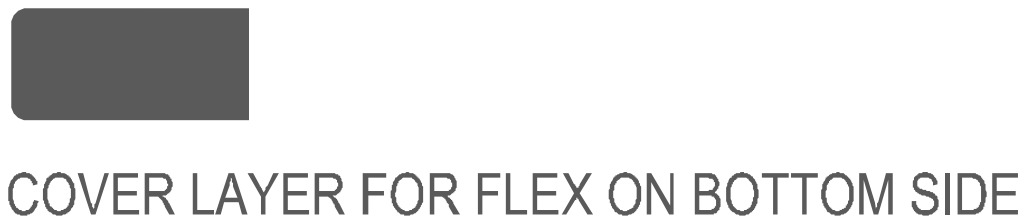
[picture p20: page 10]
