nokia/ECG-PPG-integrated-electronic-stethoscope/ECG-PPG-integrated-electronic-stethoscope-hw/PDF/Flex_PPG.PDF

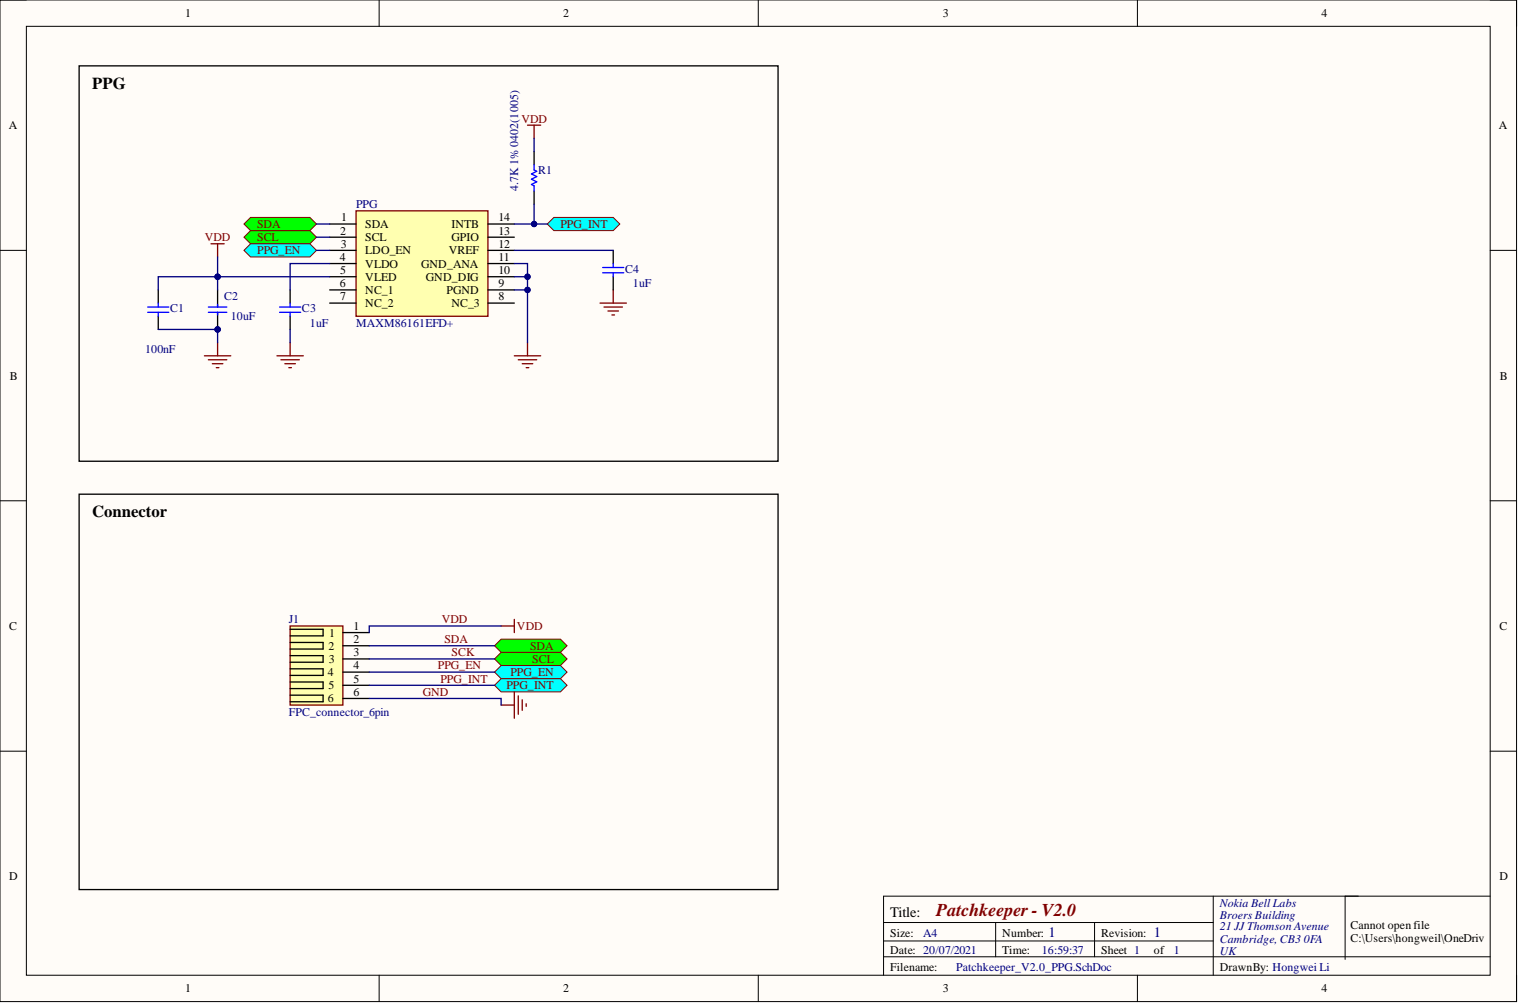
[picture p21: page 1]

Nokia Bell Labs Broers Building

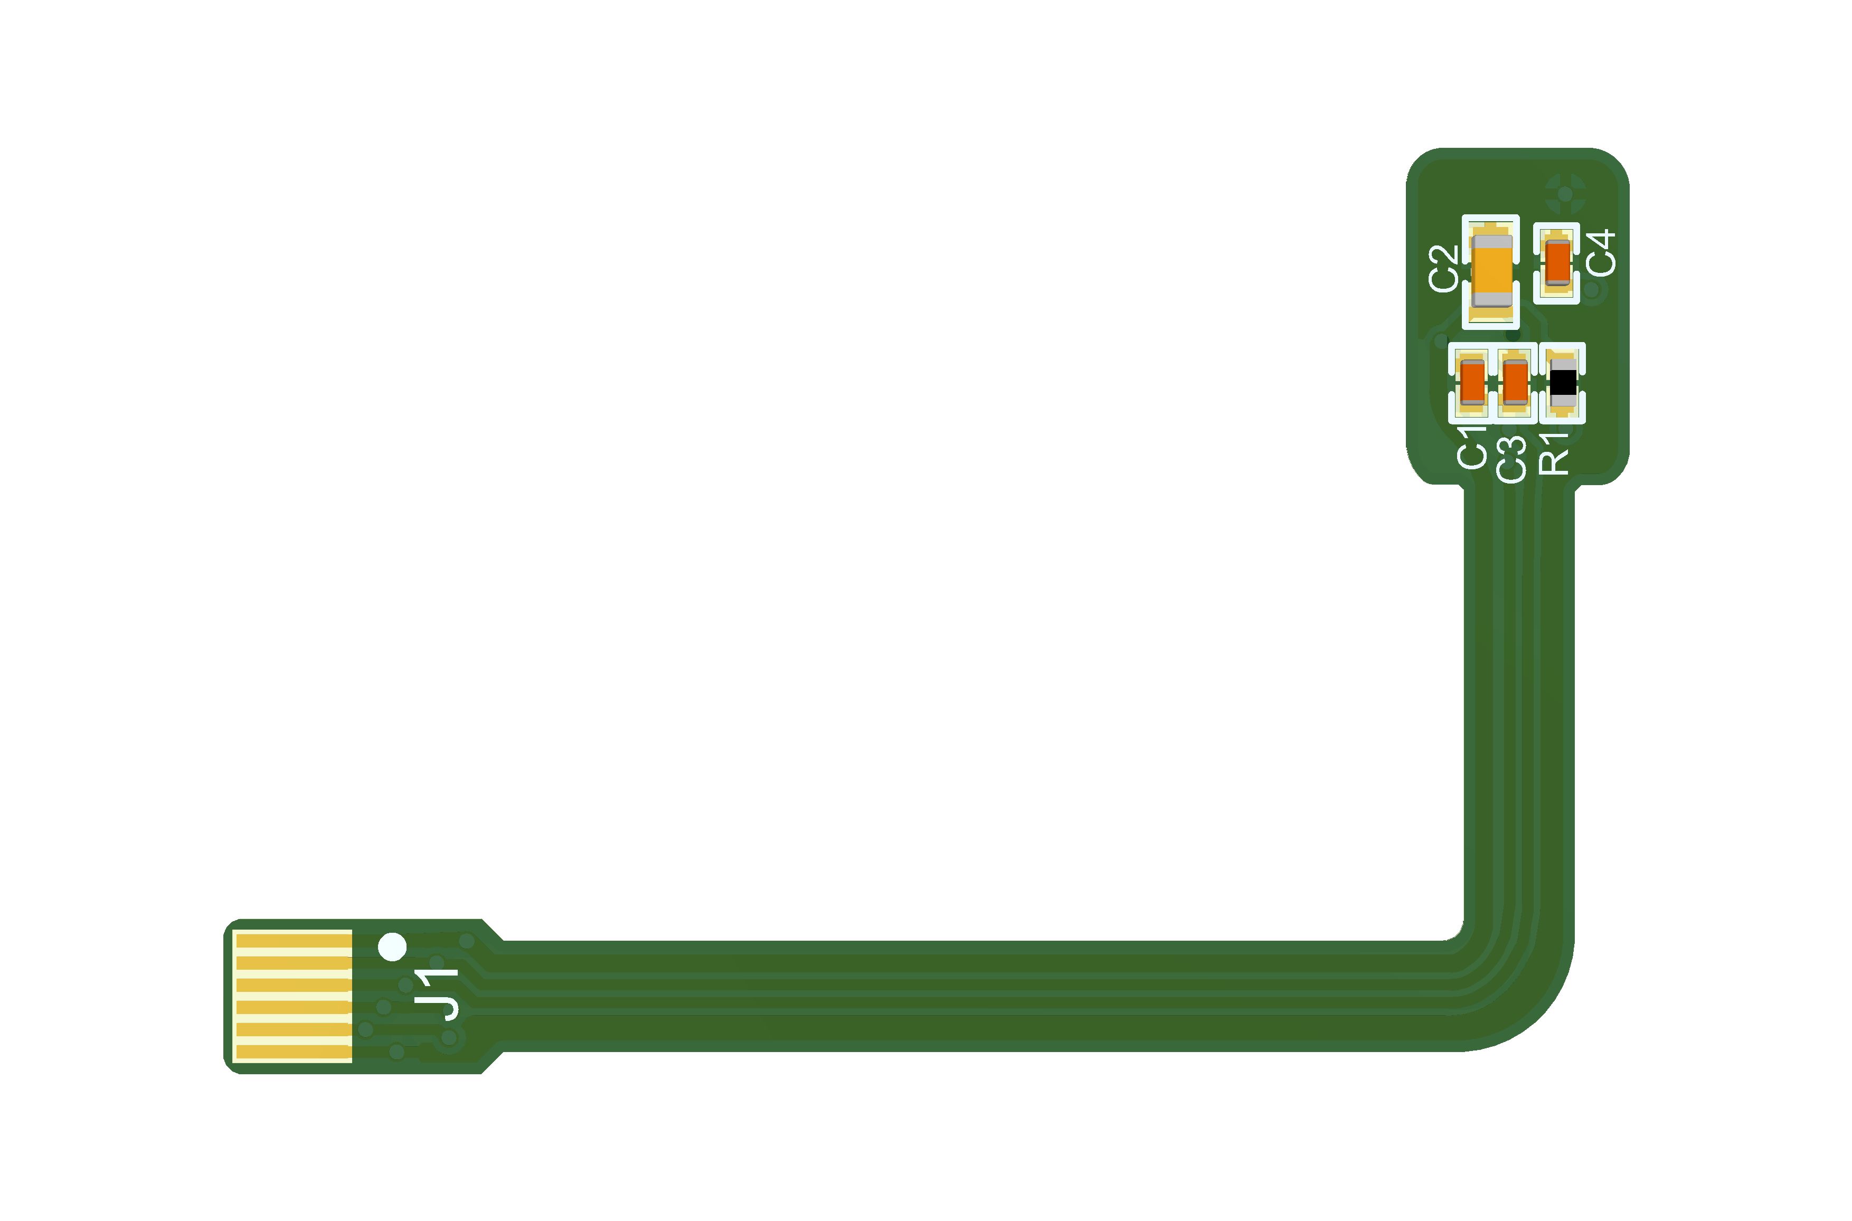
[picture p22: page 2]

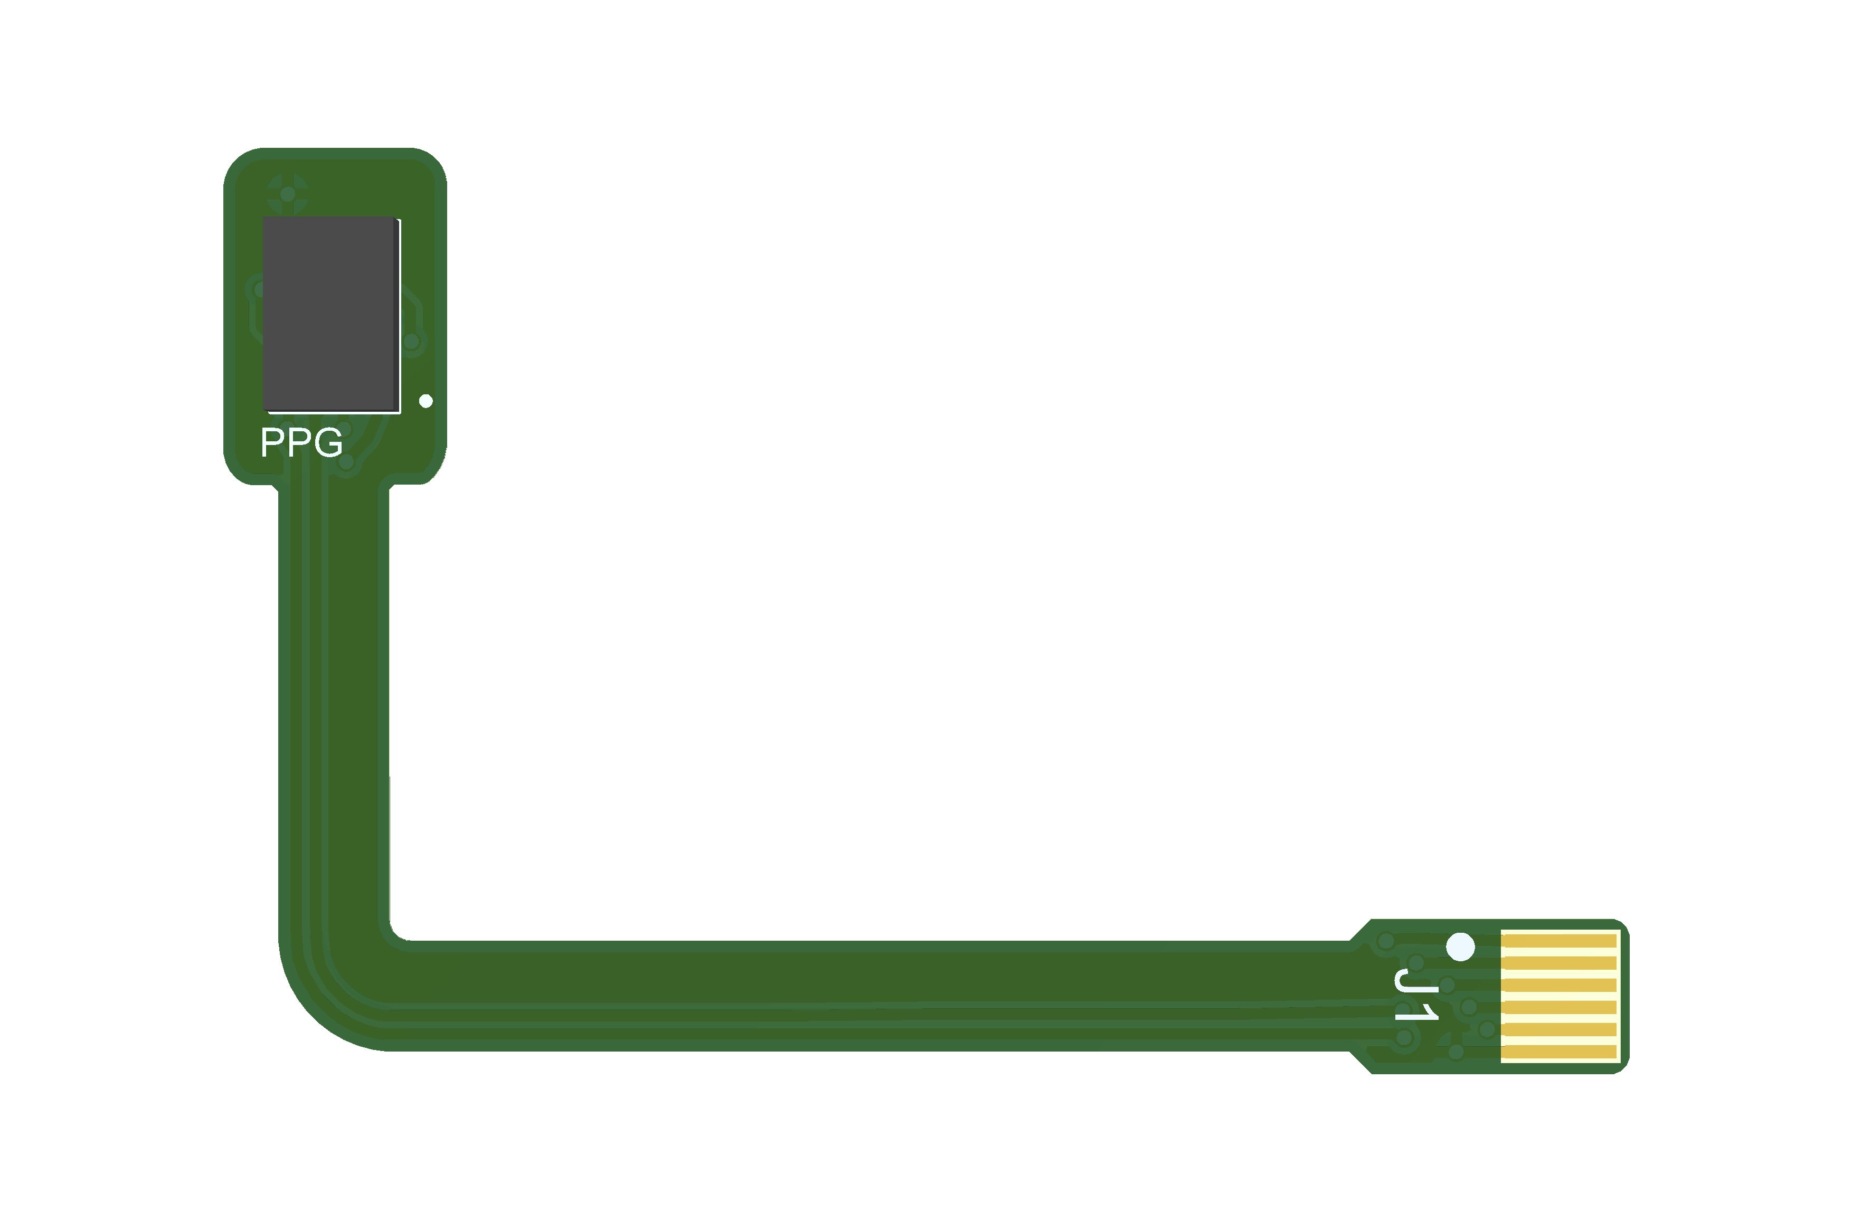
[picture p23: page 3]

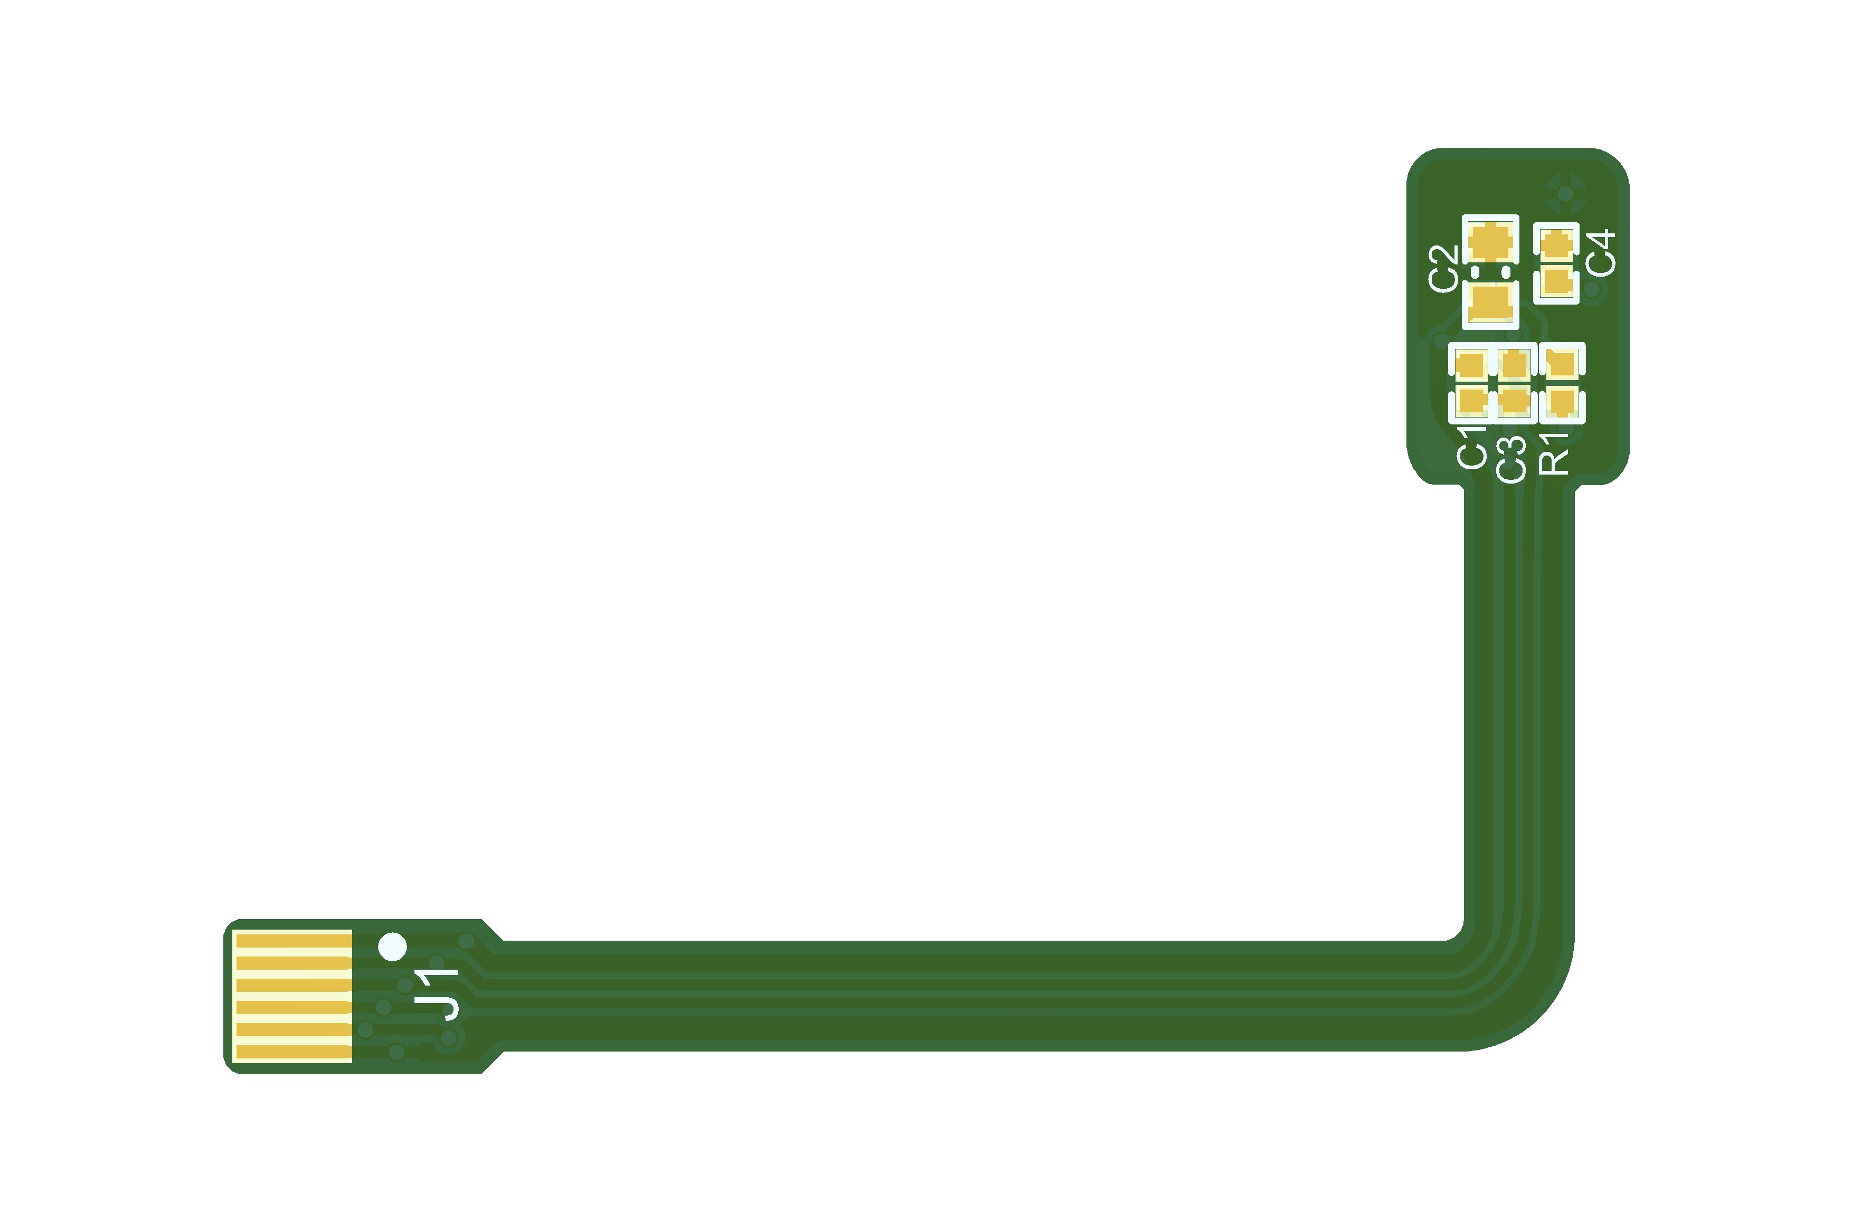
[picture p24: page 4]

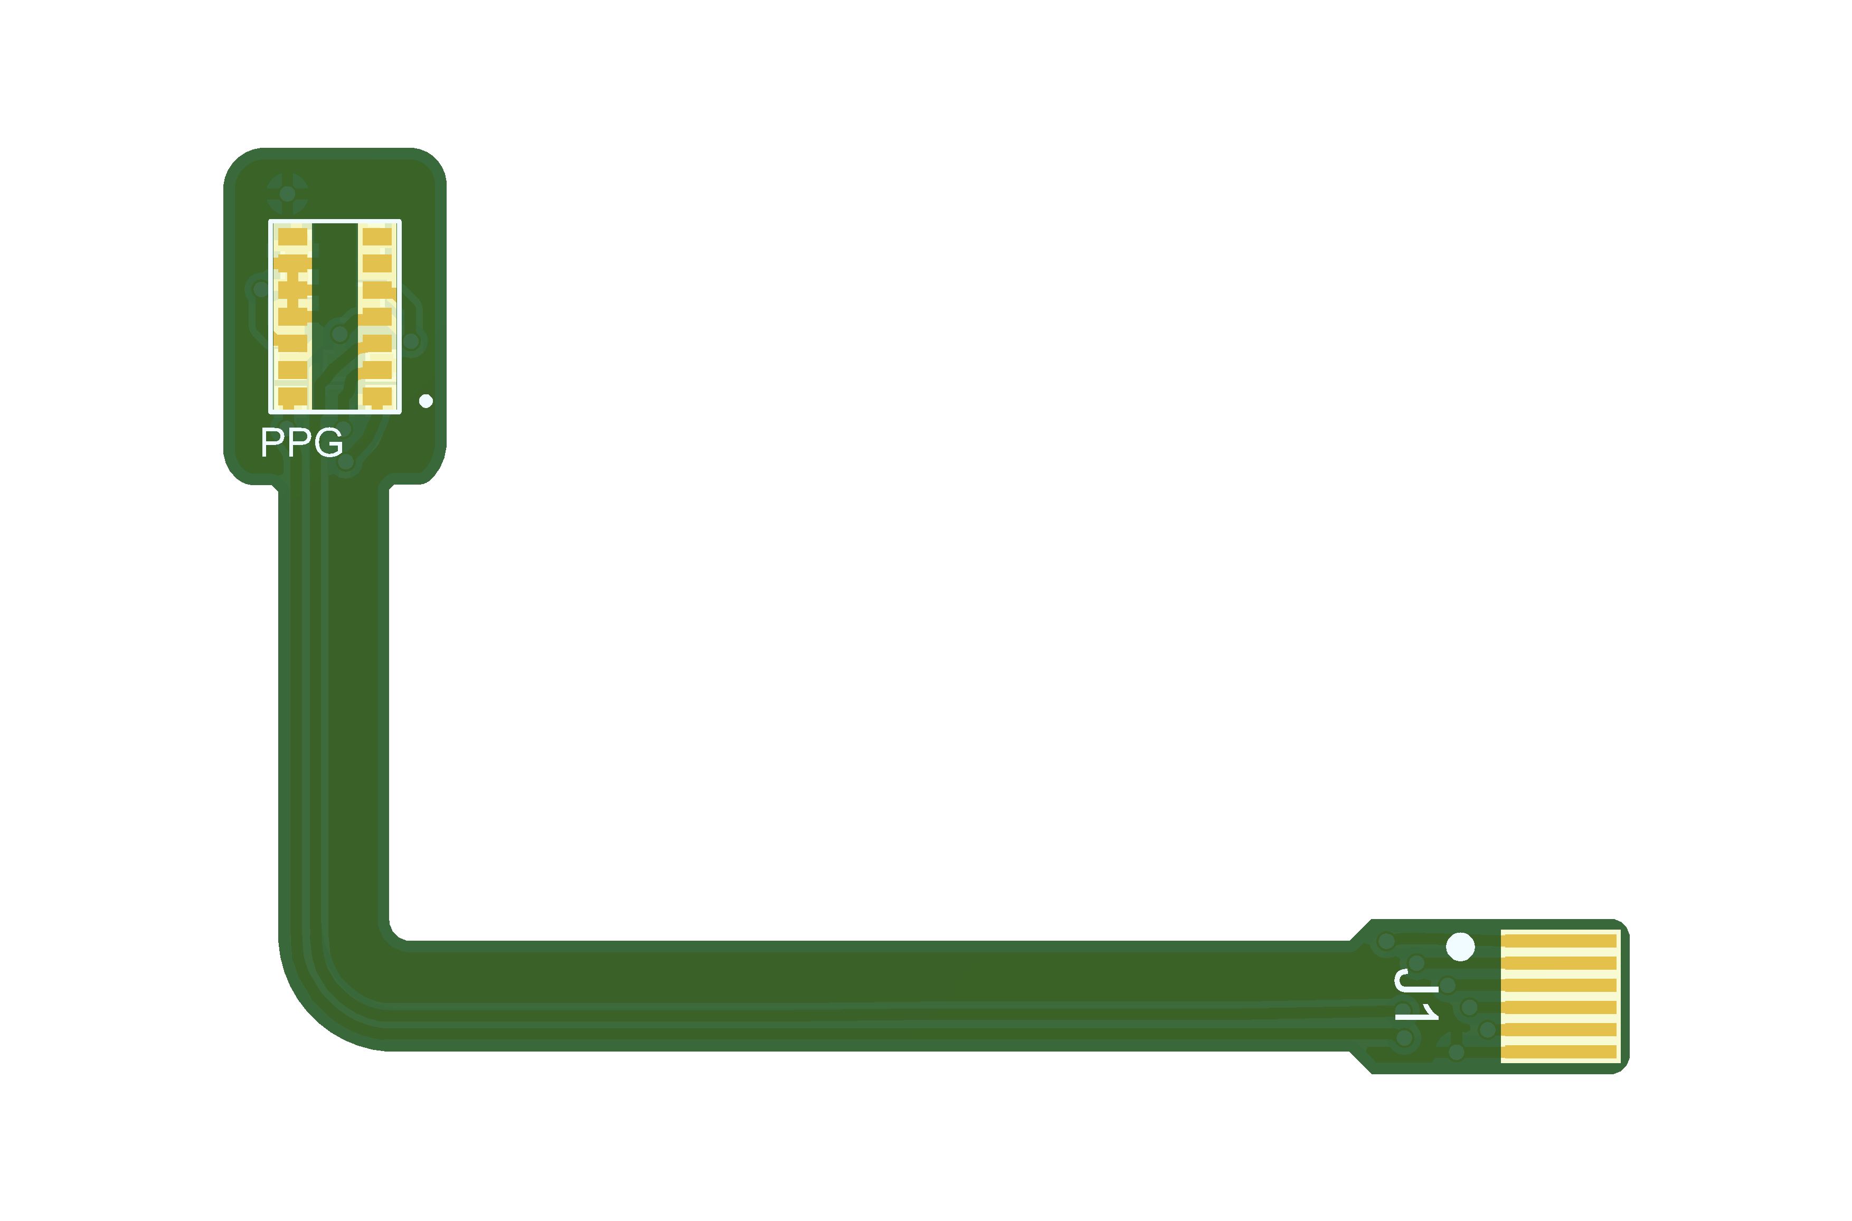
[picture p25: page 5]

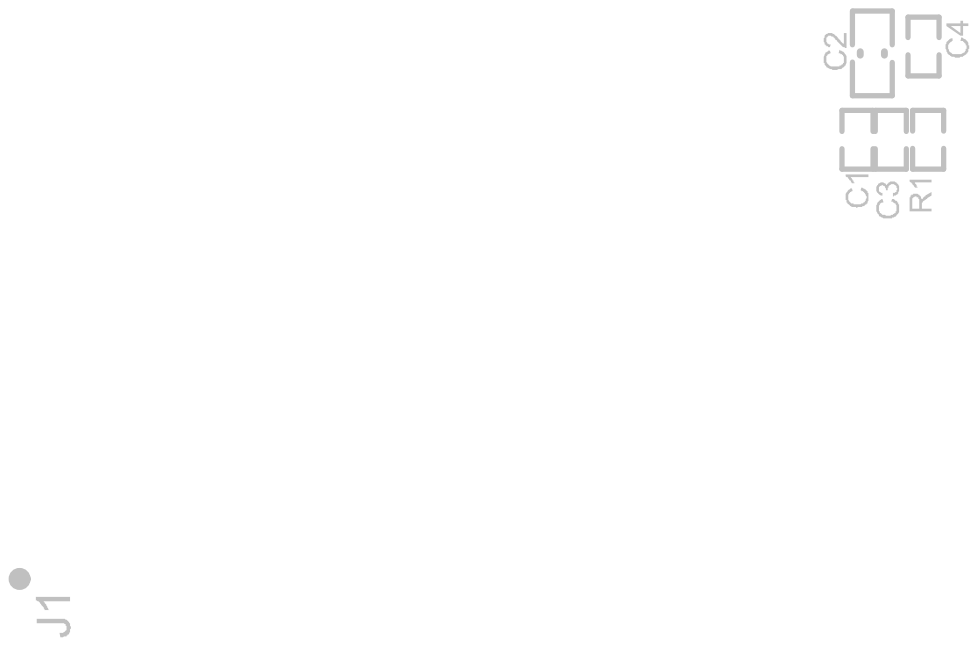
[picture p26: page 7]

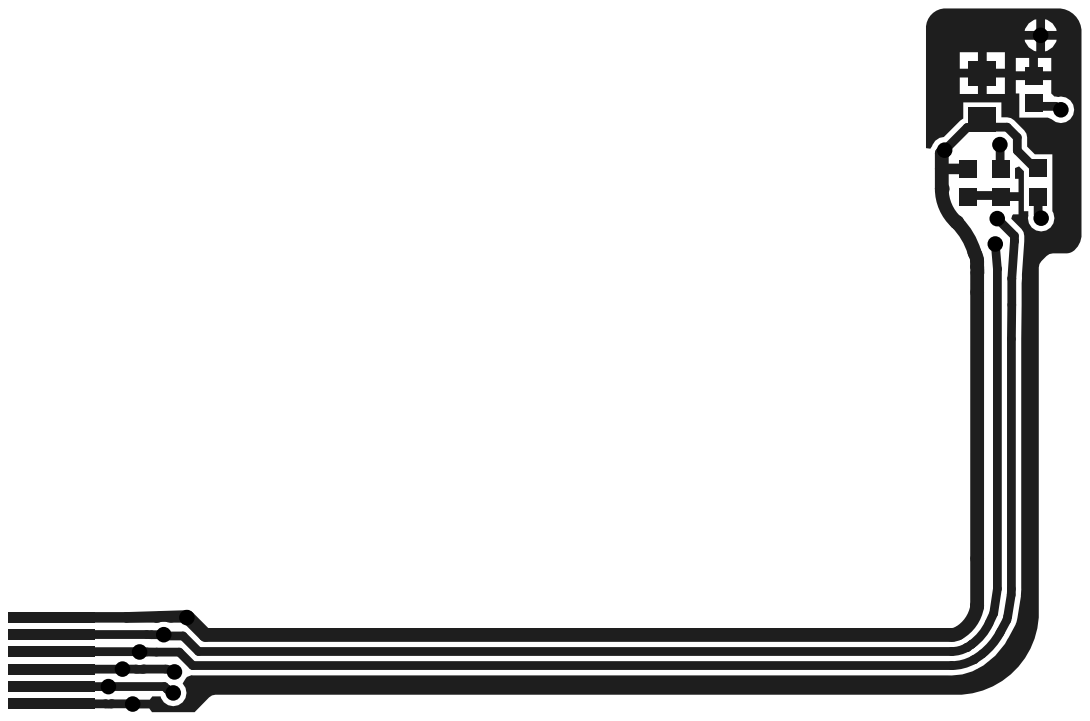
[picture p27: page 8]

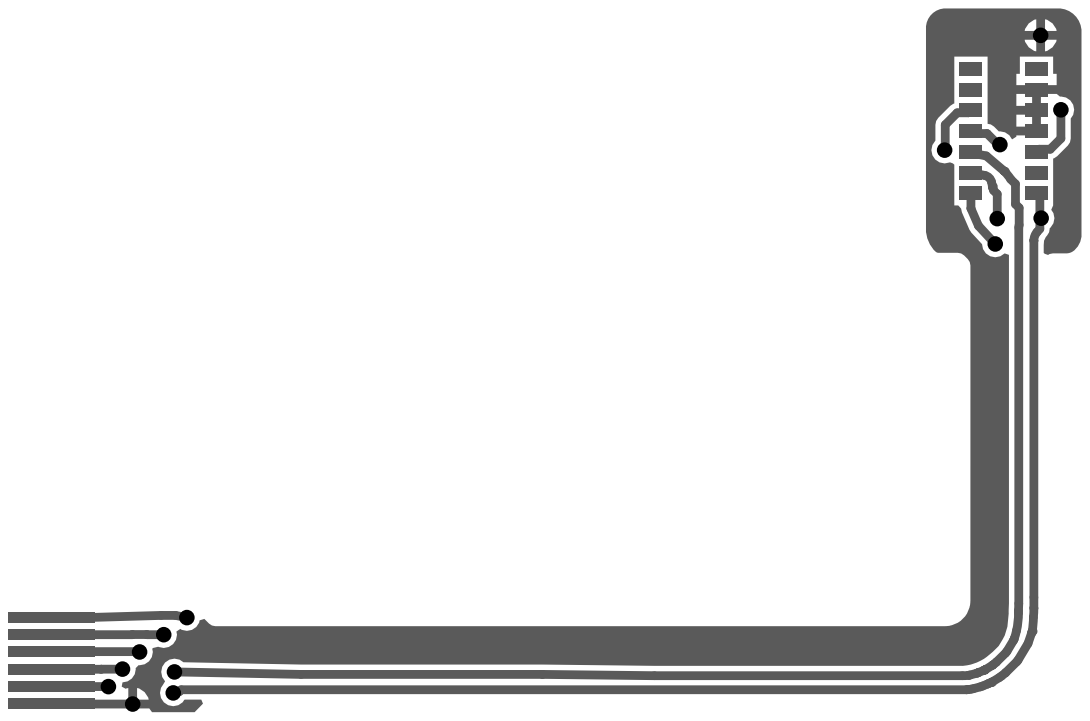
[picture p28: page 9]

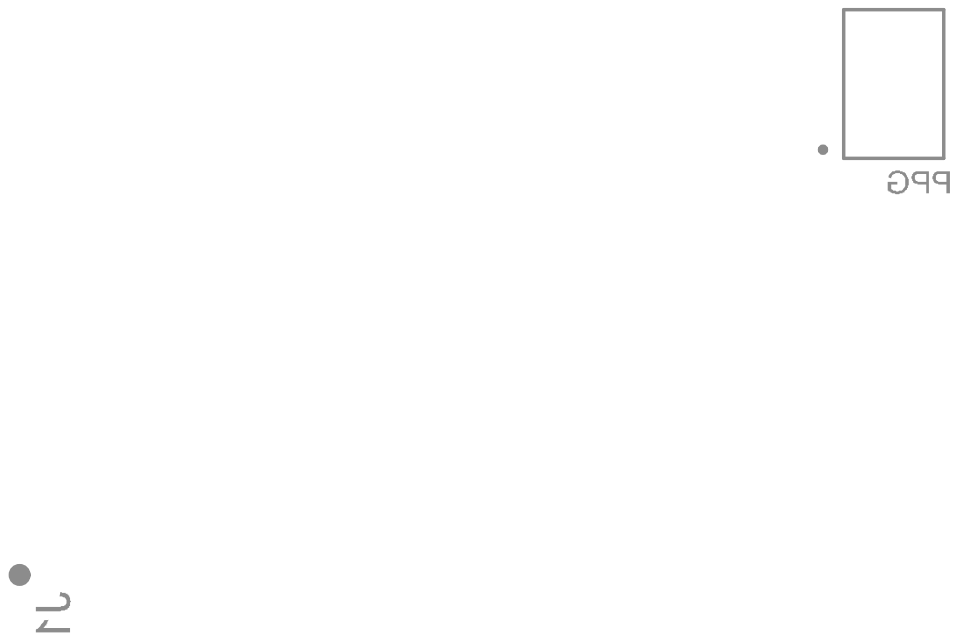
[picture p29: page 10]

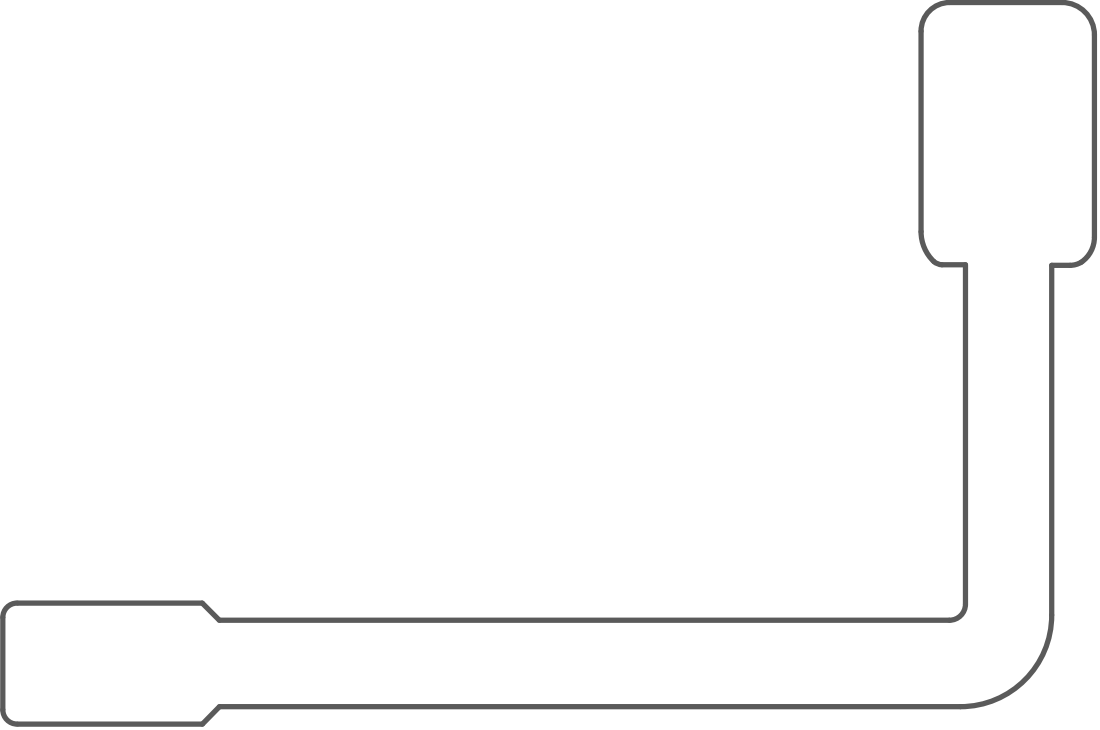
[picture p30: page 11]

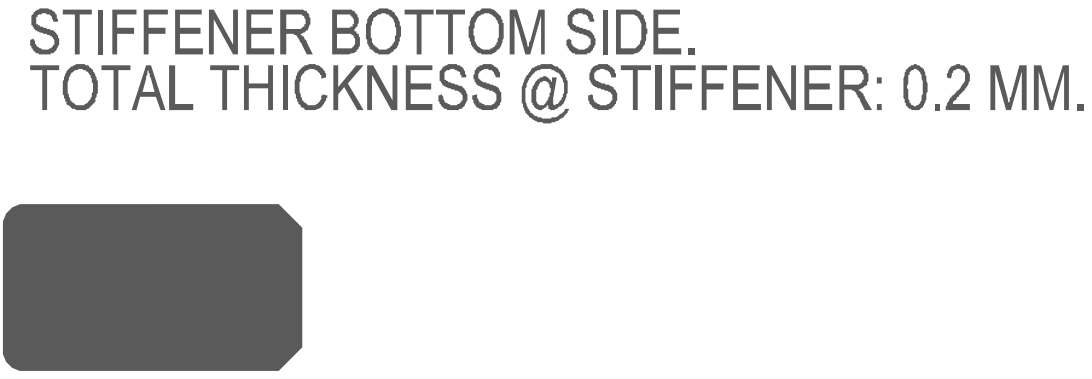
[picture p31: page 12]

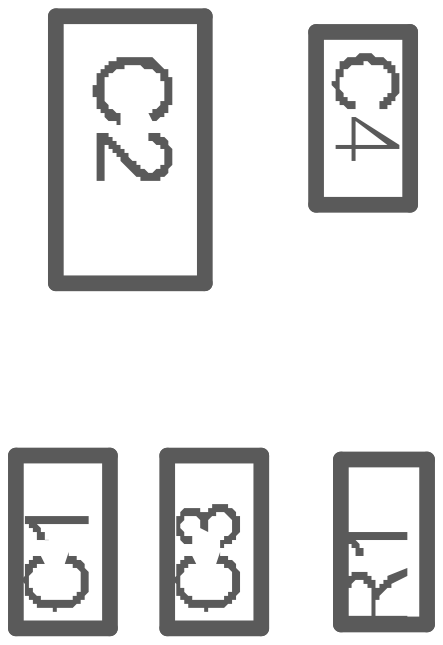
[picture p32: page 14]

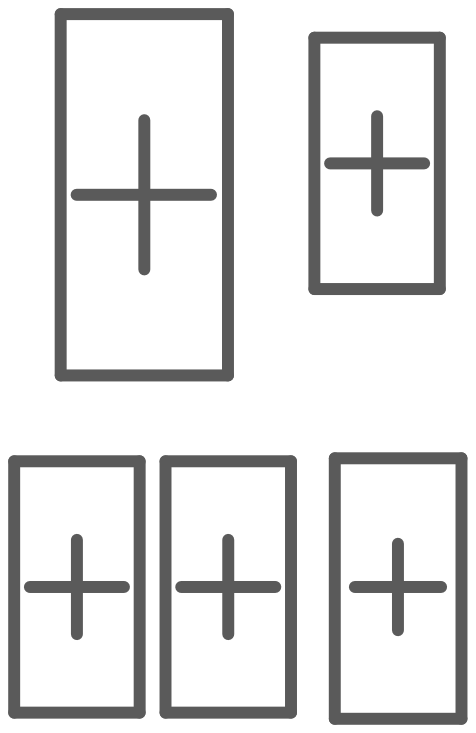
[picture p33: page 17]
