nokia/ECG-PPG-integrated-electronic-stethoscope/(commit log)

2022-12-14 Add hardware design files
    [Bill of Materials-Flex_ECG_Connector.csv, Bill of Materials-Flex_PPG.csv, Bill of Materials-PatchKeeper_V2.0(Variant ECG_FPC_Connector PatchKeeper_V2.0).csv, Flex_ECG_Connector_newshape.DXF, Flex_ECG_Connector_newshape.step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]
2022-12-18 Add firmware and documents
    [KS103J34.csv]
